SMTAFE-Engineering/CNC-Lathe-Docs/Alex's Files/Mechanical Group Rosani Sean and Alex.docx

Mechanical Group Rosani, Sean and Alex

Tasks:

- Figure out Forces that act onto the ball screw, the chip area and etc. Miguel
- Values of the lathe to be found and measured: Miguel
    - Speed of Rotation
    - Torque Needed to Cut Metal
    - Variables
    - Z is the Ball Screw
    - X is the Cutting Tool
- NSK Ball Screw, Basic Info (Alex Finished, waiting for additional data)
- Find out the Cutting Tool (Need to ask Ross)
- Find the material properties of MILD STEEL can be Generalized (Sean)
- Find the information about Cutting into Material (Sean, )
- How to use the Lathe Guide Step by Step (Sean)
- View of the Lathe, Illustration of the Lathe labelled (Rosani)
- Specifications of the Lathe
    - Specifications
    - Dimensions
- Excel Information/Equations of Cutting Forces and Calculations (Rosani)
    - Cutting Force Calculations
    - Correction Factors
    - Machine Power Requirement
- Gantt Chart (Rosani)
- Contract (Rosani)
