SMTAFE-Engineering/CNC-Lathe-Docs/Alex's Files/Tracks for lathe door in Perth.docx

Tracks for lathe door in Perth

http://www.midaliasteel.com/products/sliding-door-hardware/

https://www.robotbuildingsupplies.com.au/product/ed2-sliding-door-track/
