SMTAFE-Engineering/CNC-Lathe-Docs/Final Report/M227586 Corey Wise/FINAL REPORT CNC LATHE.pdf

South Metropolitan
Tafe
11/2017

M227586
ADV DIP
Of ENGINEERING

## COREY WISE

# LATHE AUTOMATION

CNC LATHE

TABLE OF CONTENTS 1

CNC LATHE

ABSTRACT
INTRODUCTION
BODY
CONCLUSION
RECOMMENDATION
REFERRENCES
APPENDIX

ABSTRACT | 2

The Objective of this project is to deconstruct an old manual lathe and reconstruct it as a more modern CNC lathe, which mean an automated system using computers, encoders and newly designed parts by the team

INTRODUCTION | 3

CNC lathes are now a staple and important part of the manufacturing industry since most or all Lathe are CNC because its computerized and easily able to manufacture objects beyond the skill level of most machinists and create otherwise timely and technically challenging materials with ease.
During our time trying to finish this project our main object is to finish the Z-axis and X-axis and possibly the tool changer, unfortunately not all the objectives we aimed for we accomplished
Throughout this report I will identify things I have done and helped with during the duration of the report
The reports body will be separated into three parts design, manufacturing and research
Then I will discuss what could have been done better and more efficiently

BODY - RESEARCH 4

The Body will consist of 3 main steps the we took as a whole team during every specific task, which was first to research it then to design either a work around or a better design and lastly to get it manufactured.

## RESEARCH

During the starting step of the Project we were tasked with research specific part of a CNC LATHE and compiling that knowledge in a collective program called GITHUB, I personally was tasked with finding out the base prices of CNC lathe and also compiling them into a bill of materials so the cost of such extra materials such as motors and encoders as well as sensors, came into play. Finding such prices of encoders and servo motors was also a part of my specific research what was there RPM and finding there Torque. Finding a coolant pump and how big we needed it and what specific coolant we would be using was also needed. See appendix 1
When researching the ball screws with Miguel we used a formula to make sure it could with stand the load that would be forced upon the axis
Researched ball screws, the formula need and using this calculated the ball screws needed for our lathe

# LLLLLLLL = CCℎuuuuuu aaaa aa aa vv vv vvvvvv (RRRRRR) × FF

## mmmm

# aaaa aa aa vv vv vvvvvv (RRRRRR)

# TTbbbbbbbb ssssssssss = FFmmmmmm × LLLLLLLL 2ππ × ηηbbbbbbbb ssssssssss × 1000

With these two formulas and also the breakdown of our forces and determining the cutting forces (produced by Miguel) we were able to obtain the toque on the ball screws. For the z-axis or The Apron we got a total force of 4632.5N

# FFmmmmmm = FFFF + FFAA = 1182.5NN + 3450 NN = 44444444. 5555

Then using the above ball screw formula we get 8.2Nm
And apply the safety factor we obtain the final 10.9Nm Repeating this method for the x-axis or tool post

BODY RESEARCH/DESIGN 4
We get 22 22. for total collective force which makes our ball screw torques

5.1Nm which makes it 6.8Nm with a safety factor.
I also did extensive research on the CNC Lathe Cover and what type of material what slide would work the best, and what type of shape would be acceptable for us to build given our motors being unattached to our CNC saddle.

## DESIGN

After extensive research we approached the design stage of the project, which started off with pulling apart the CNC lathe and every person taking a few bits of the lathe and designing in AUTO CAD to create a virtual assembly of the lathe so we design any extra bit to add onto the lathe so we could add such thing as the ball screws and servo motors.
I personally designed the X axis saddle and the Lathe cover, and the old manual tool changer which was not needed for the design so it was scraped before finish.

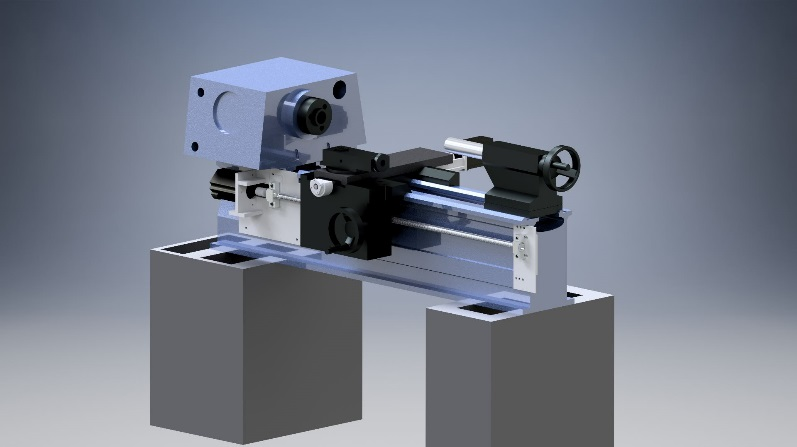
[picture p92: figure]
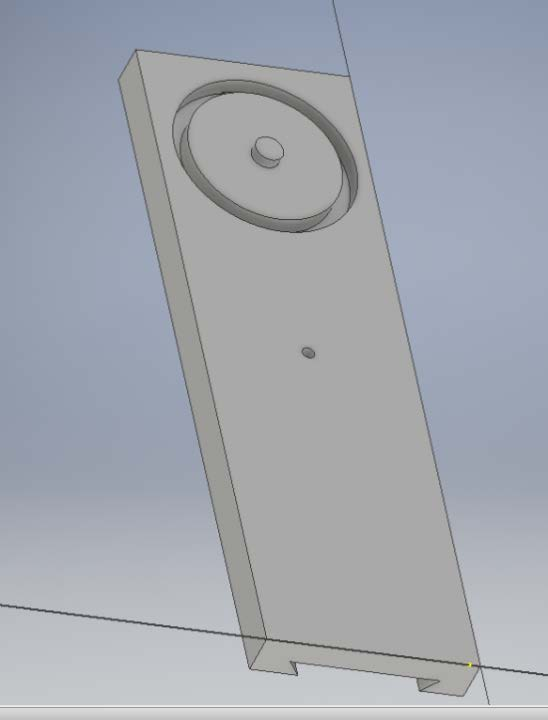
[picture p93: figure]
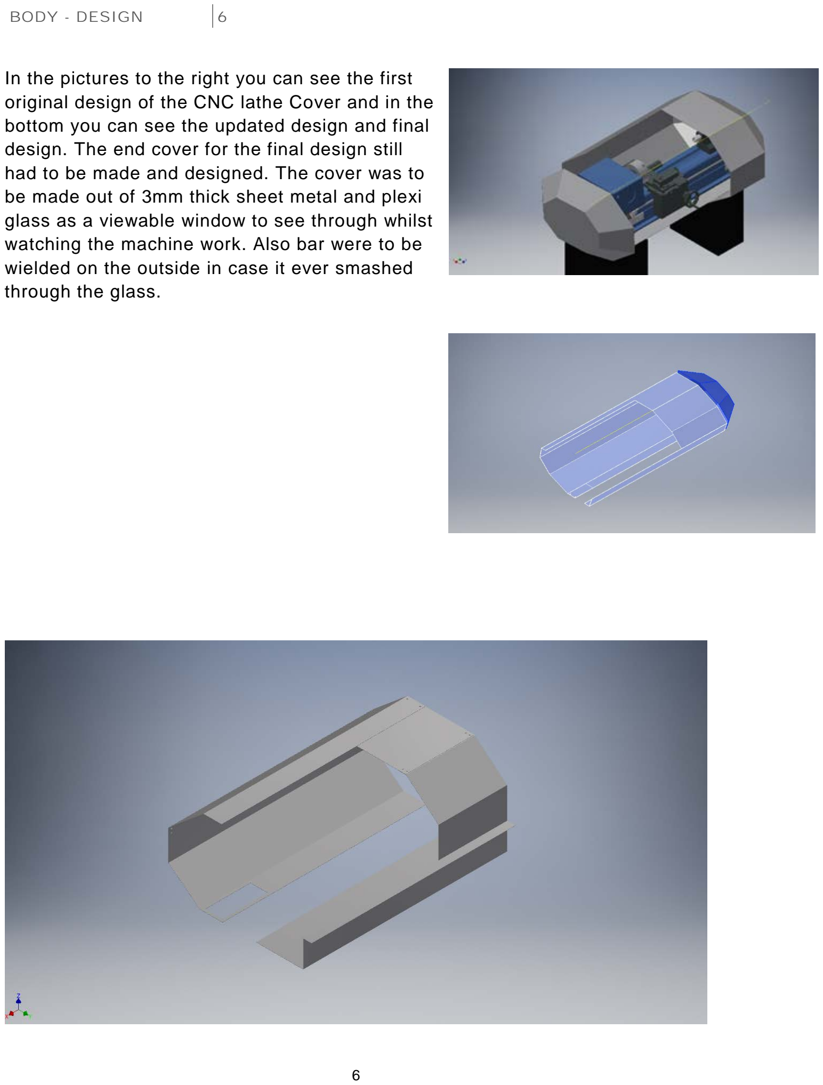
[picture p94: page 7]

BODY - DESIGN | 6

In the pictures to the right you can see the first original design of the CNC lathe Cover and in the bottom you can see the updated design and final design. The end cover for the final design still had to be made and designed. The cover was to be made out of 3mm thick sheet metal and plexi glass as a viewable window to see through whilst watching the machine work. Also bar were to be wielded on the outside in case it ever smashed through the glass.

BODY – MANUFACTURING/CONCLUSION 7

## MANUFACTURING

During my time on the project the only thing I had to manufacture was the lathe cover but was taken over fully by Sean after the first design to make the drawing but it was never manufactured. The design can be easily adapted into a manufactured part later. Things like the ball screw supports were properly manufactured and the ball screws selection were purchased and added which are the main things need to at least get the lathe running to standard but it would not be safe until the cover was installed

## CONCLUSION

In conclusion it was obvious that the design and manufacturing process of our project were clearly strung out and ineffective in achieving an end result as a group our efficiency in completing designs and also bring most objects to the manufacturing stage could have been far more desirable.
I could have also be more efficient with my time and help out other parts of the project that I was not actually a part of.
This was about the extent of my input during this year it wasn’t as much as it could have been but I was looking forward to getting the assembly stage and getting more hands on because I think that is where I could of displayed more of my practical skill such as wielding and machining to help complete the physical product more than the virtual product.
There was work to be done but our communication as a team was lacking know what was free to be worked on or who needed help or anything that need to be improved.
In regards to the project as a whole the virtual side of things was finished but the physical was not

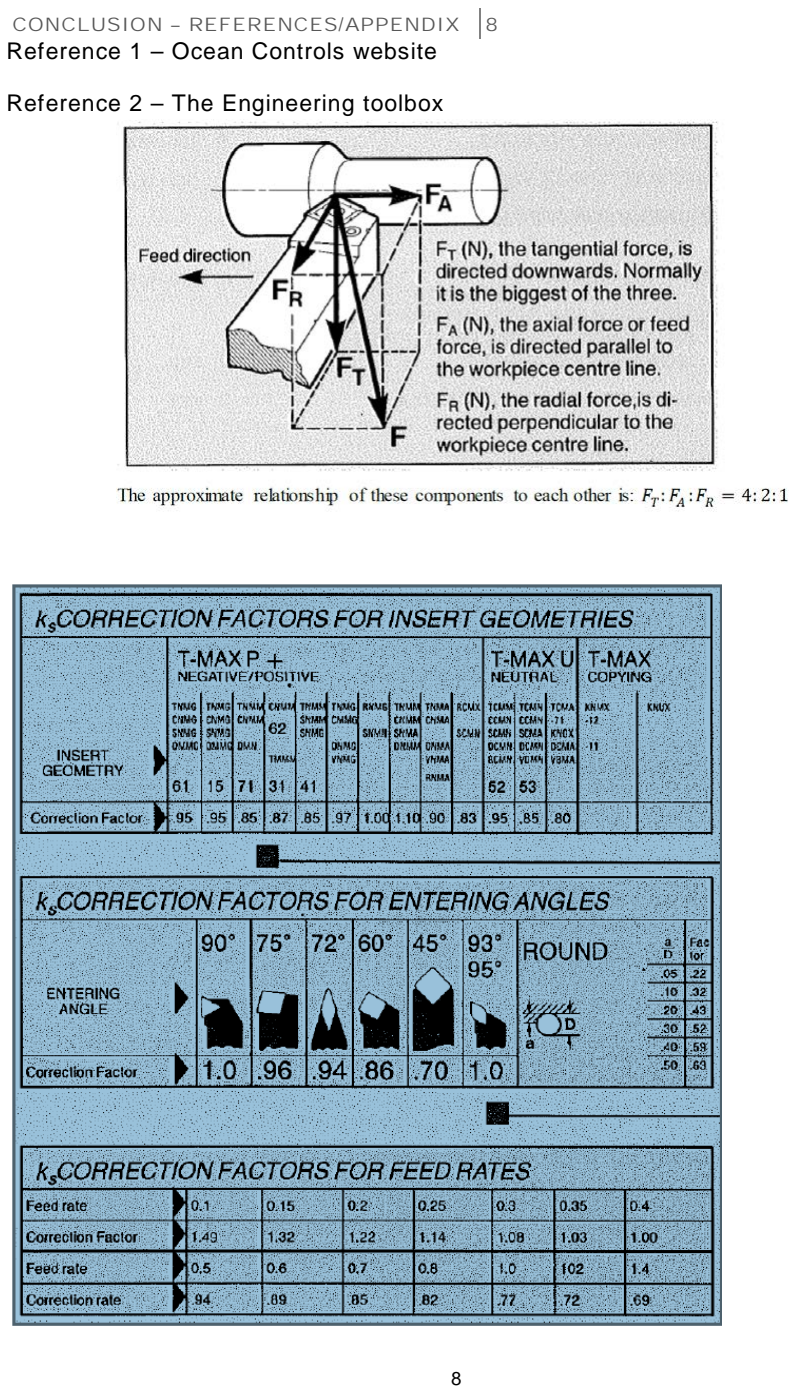
[picture p95: page 9]

CONCLUSION – REFERENCES/APPENDIX 8 Reference 1 – Ocean Controls website Reference 2 – The Engineering toolbox

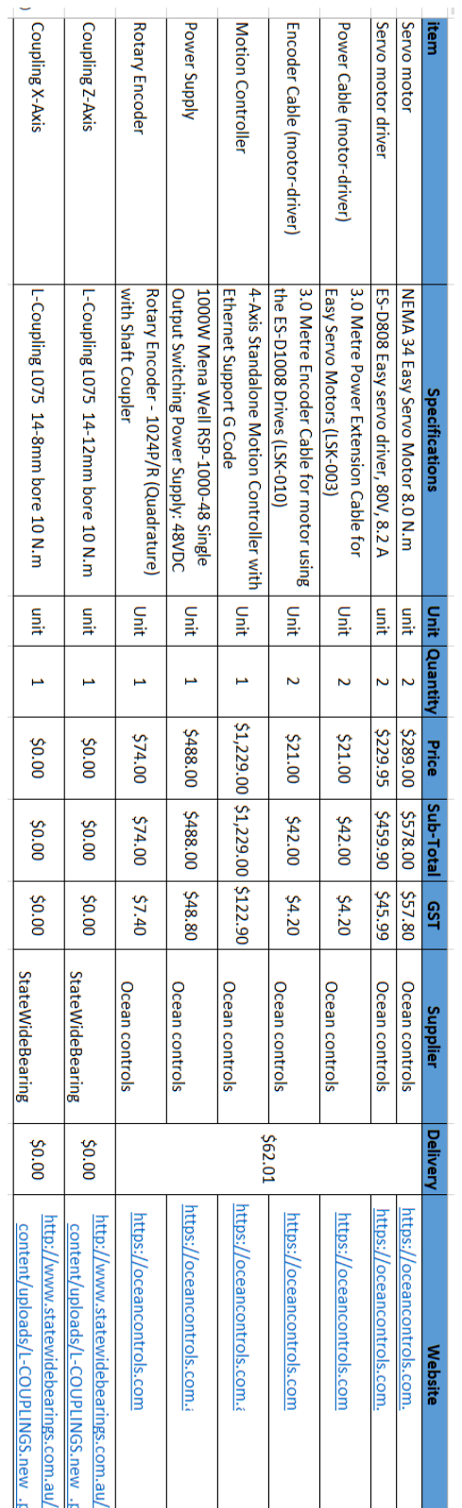
[picture p96: page 10]
