SMTAFE-Engineering/CNC-Lathe-Docs/Final Report/M228540 Miguel Martins/Final report.pdf

# LATHE AUTOMATION

Tuesday 28/11/2017
Advance diploma of mechanical engineering Miguel Martins M228540

## Contents

## Introduction

Lathe has been an important tool for the industrial revolution. It has been considered as a must-have tool for the manufacturing industry offering reliable and accurate result. However, in the last decade automatic lathes have taken over this process due to its low cost, manufacturing errors reduction and human safety benefits. Furthermore, the intent of stepping into this technology is fundamental giving basic comprehension and skills required by today’s challenges.

This report consists of four sections:
1. Modelling
2. Calculations.
3. Manufacturing.
4. Assembly.

In this order, modelling refers to the process of digitalizing a physical component into a computational 3D model while calculations will involve some research and force analysis develop during operation. These two sections will be carried out individually where every person will have a different task while the manufacturing process will be operated by an authorised machinist. Moreover, assembly, wiring and programmable set up sections will be done in collaboration.

By the end of this project, operators should be able to machine a material by giving it a specific drawing file which will be then translated and transformed into GCODE files and lastly be readable by the motor controllers.

## Modelling

The following components were part of my collaboration to the team. Apron

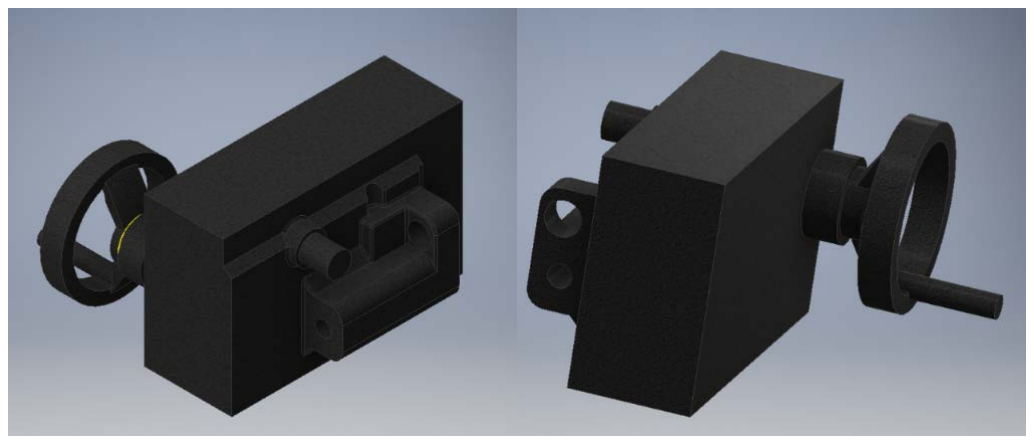
[picture p97: figure]

Bed

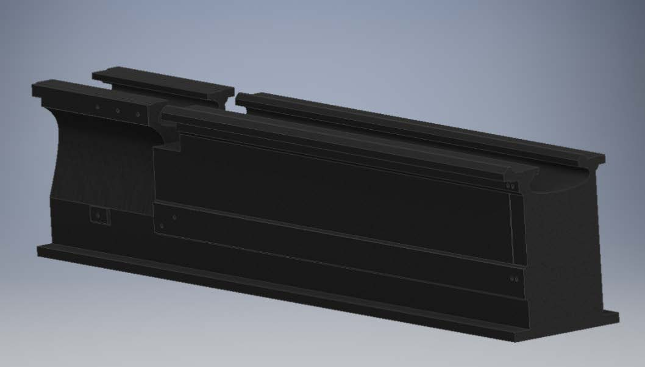
[picture p98: figure]

## Calculations

Torques and forces exerted by the lathe were calculated in order to select both motors and ball screws.
Initial stablished parameters:
Predominantly material for workpiece | High Carbon Steel | N/A
Depth of cut (max) | 6 | mm
Feed rate (max) | 0.5 | mm/rev
Chuck angular velocity (max) | 22 - 1800 | RPM
Coefficient of friction metal-metal | 0.16 (The Engineering ToolBox, 2017) | N/A
Z-axis weight | 50 | Kg
X-axis weight | 25 | Kg
Manual angular velocity | 120 | RPM
Lead angle accuracy | 0.05 | mm
Ball screw length to be used for the Z-axis | 1100 | mm

CNC lathe is required to be driven by ball screws and servo motors for their lowest factors of frictions and accuracy respectively. Therefore all following calculations are aimed at selecting a ball screw and a servo motor that can overcome the maximum torque, velocity and forces developed by the lathe.

For cutting force calculation:

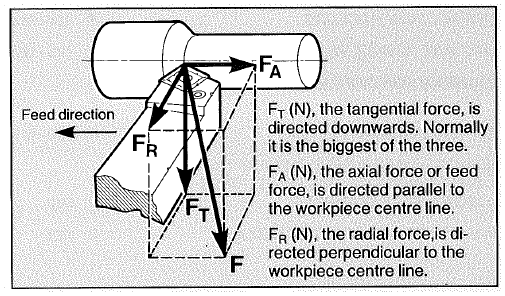
[picture p99: figure]

The approximate relationship of these components to each other is: FFTT: FFAA :FFRR = 4: 2:1

Tangential cutting force (FFtt ) may be determined by:

# FT (N) = ks × a × s

Where | kkss = | specific cutting force (N/mm²)
a | = | depth of cut (mm)
s | = | feed (mm/rev)
As kkss = 2300 N/mm² for a workpiece of high carbon steel, it need to be corrected by three (3)

factors which are insert geometry, entering angle of the tool and the feed rate chosen. See appendix 1 for more information.
Assuming all these factors are equal to one, kkss is:

# kkss = 2300 × 1 × 1 × 1 = 22222222 NN/mmmm22

Thus,

# FFTT = 2300 NN/mmmm2 × 6 mmmm × 0.5 mmmm/rrrrrr = 6666 NN

And:

# FA = FT

2 = 6900 NN
2 = 3333 NN

# FR = FT

4 = 6900 NN
4 = 1111 NN

Since the lead angle accuracy is 0.05 mm and the effective thread length is greater than 1000 mm, the accuracy grade for the ball screw will be C5 Precision Ball Screw. Furthermore, most ball screw can provide an efficiency of 95%.

Additionally, the ball screw lead may be obtained as follow:

# LL LLLL =

# CCℎuuuu aaaa aa vv vvvvvv (RRRRRR) × FF rr rr

### mmmm

## rrrrrr

# aaaa aa vv vvvvvv (RRRRRR) = 1800 × 0.5

120

# = . mmmm/rrrrrr

Rounding up the theoretical lead to match a standard lead screw ball from manufactures, lead is equal to 10 mm/rev.

Once cutting forces and ball screw’s lead have been calculated, forces due to friction and lathe’s components weight must be included for both X and Z axes. Thus,

Z-axis (Apron) | X-axis (Tool post)

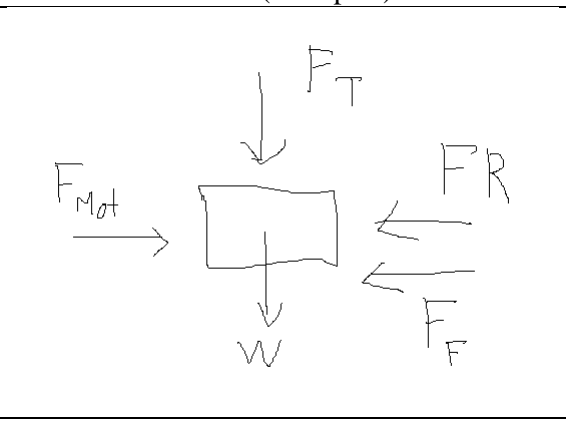
[picture p100: figure]
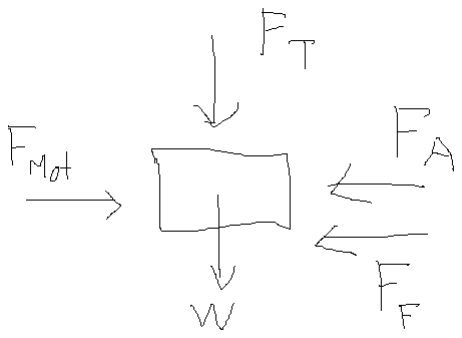
[picture p101: figure]

WW = 50KK × 9.81 mm/ss2 = . NN FFFF = (6900NN + 490.5NN) × 0.16 | WW = 25KK × 9.81 mm/ss2 = 22 . NN FFFF = (6900NN + 245.5 NN) × 0.16
= 111111 . FFmmmm = FFFF + FFAA = 1182.5NN + 3450 NN | = 1111 .22 FFmmmm = FFFF + FFRR = 1143.2NN + 1725 NN
= . | = 22 .22

# TTbbbbbbbb ssssssssss = FFmmmm × LL LLLL 2ππ × ηηbbbbbbbb ssssssssss × 1000

# = 4632.5NN × 10 mm/rev 2ππ × 0.9 × 1000 = . 22 NN

# TTbbbbbbbb ssssssssss = FFmmmm × LL LLLL 2ππ × ηηbbbbbbbb ssssssssss × 1000

# = 2868.2NN × 10 mm/rev 2ππ × 0.9 × 1000 = . 11 NN

Considering all the previous values and space limits, the ball screw selected could be found on appendix 2. Furthermore, a 3D representation of the ball screw was drawn by using the dimensions shown on the appendix 2.

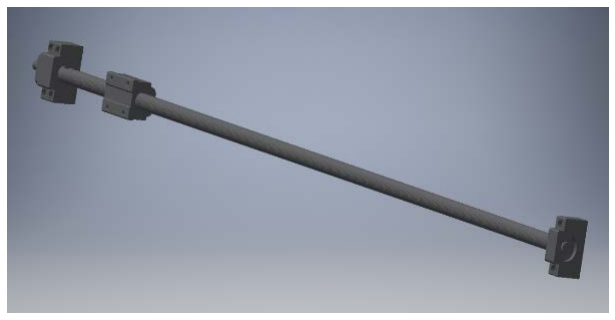
[picture p102: figure]

Finally, selecting the motor is done by using the maximum torque calculated previously and the assumed rotational speed. The motor details are shown on appendix 3. (Ocean Controls, 2017)

## Manufacturing

Having all the dimensions for the ball screw and the motor to be used, supports can be designed and adapted to the lathe in a convenience manner.

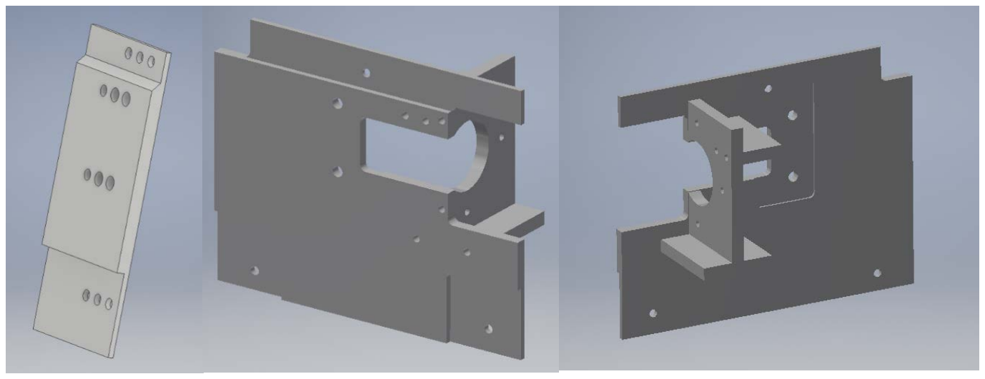
[picture p103: figure]

Then, manufacturing drawing were created and handed to the machinist.

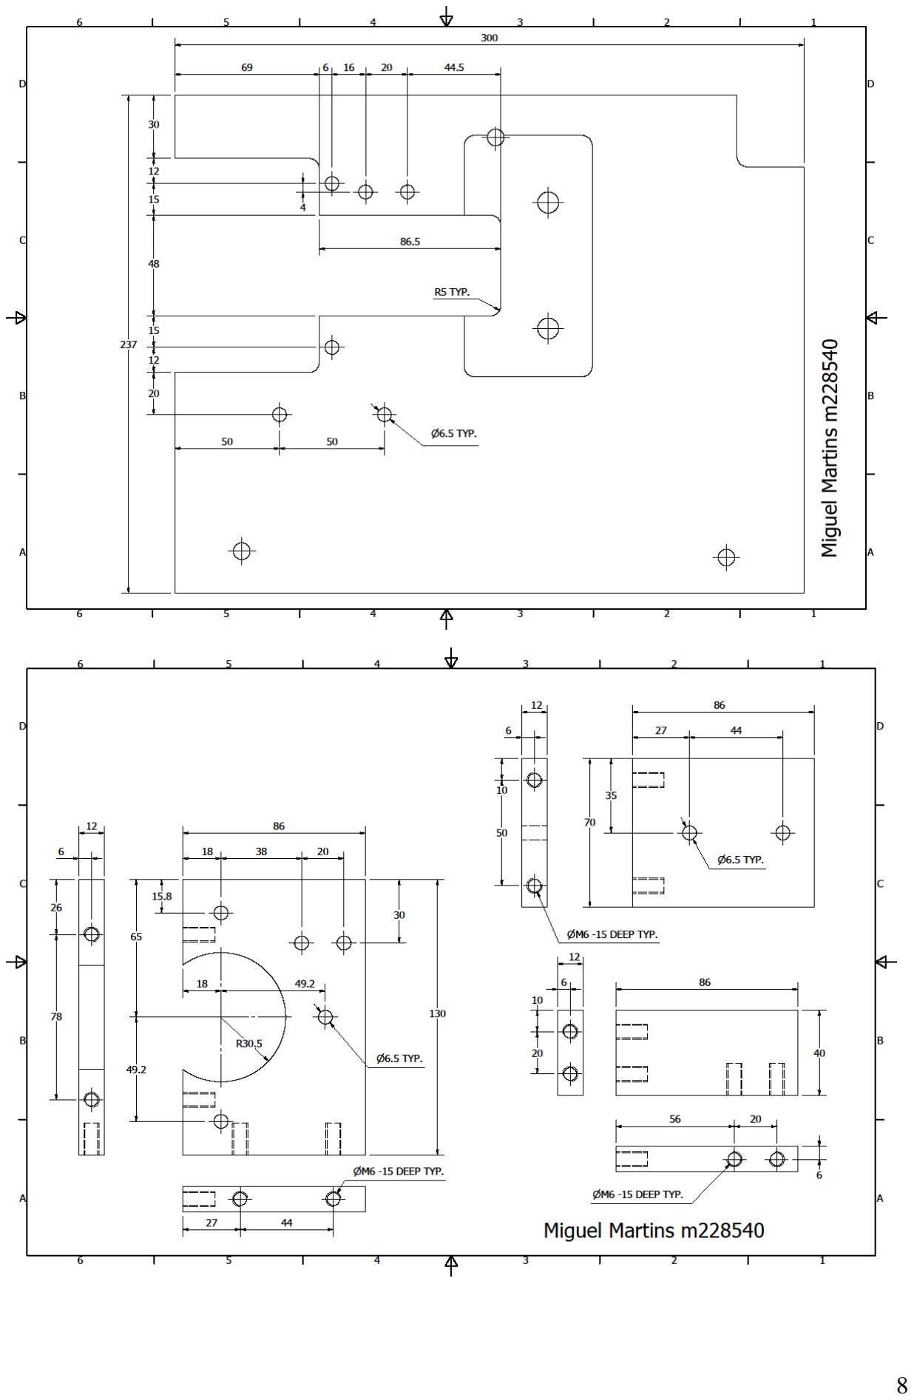
[picture p104: page 8]

## Assembly

Unfortunately, this section was only accomplished on a 3D model because machinists and lectures were unavailable. However, supports were machined partially and some modifications were added to it afterwards due to some discrepancy on the flexible couplings.

In addition, the final 3D model was designed to allow movements and test the maximum possible displacements after all components being assembled. Finally, the 3D representatio n of the final assembly is:

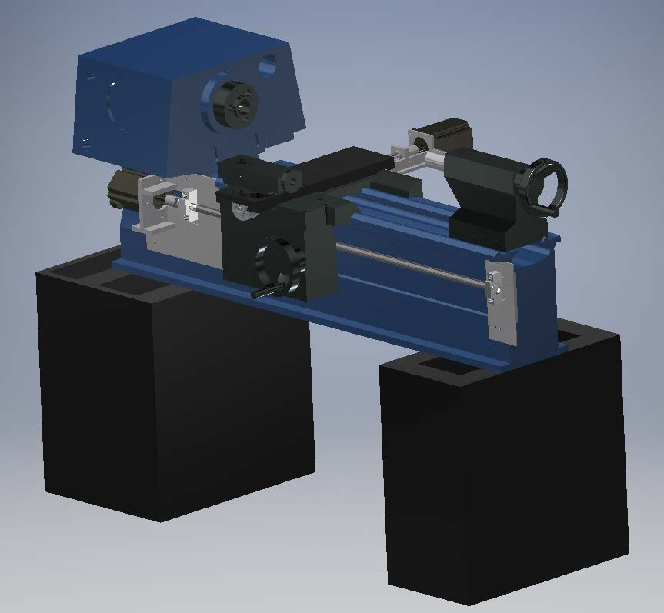
[picture p105: figure]

## Conclusion

Although we finished off the virtual representation of the final assembly, the physical assembly could not be done due to circumstances out of our control. Furthermore, all the basic selections like motor and ball screw were carried out without major difficulties. As mention previously, what was done of the supports was also tested on the bed and fitted correctly with aligned holes and proper dimensions.

Regarding the z-axis configuration which was my task, there was not need of modifying neither the apron nor the bed for the nut or ball screw’s supports to fit in. This was accomplished by selecting the most suitable ball screw and playing around with the design of its supports. As it can be seen, these supports were machined on both front and rear surfaces which avoided us modifying the apron or bed.

Finally, all the calculations were proven to be the most suitable for our application due to a interactive spread sheet on Excel were initial values can be changed and see the result right away. It is worth mentioning these initial values were obtained from machinist and lecture’s experiences and used as a starting point or initial reference.

## Recommendations

In order to complete this project, ball screw’s supports must be finished off as indicated on manufacturing drawings.

Motors must be place in a convenience way where cables go towards the motor controllers

## References

Ocean Controls. (2017, July 18). NEMA 34 Easy Servo Motor 8.0 N.m. Retrieved from oceancontrol.com.au: https://oceancontrols.com.au/MOT-184.html
The Engineering ToolBox. (2017, July 18). Friction and Friction Coefficients. Retrieved from Enginnering ToolBox: https://www.engineeringtoolbox.com/friction-coefficients-d_778.html

## Appendices

Appendix 1

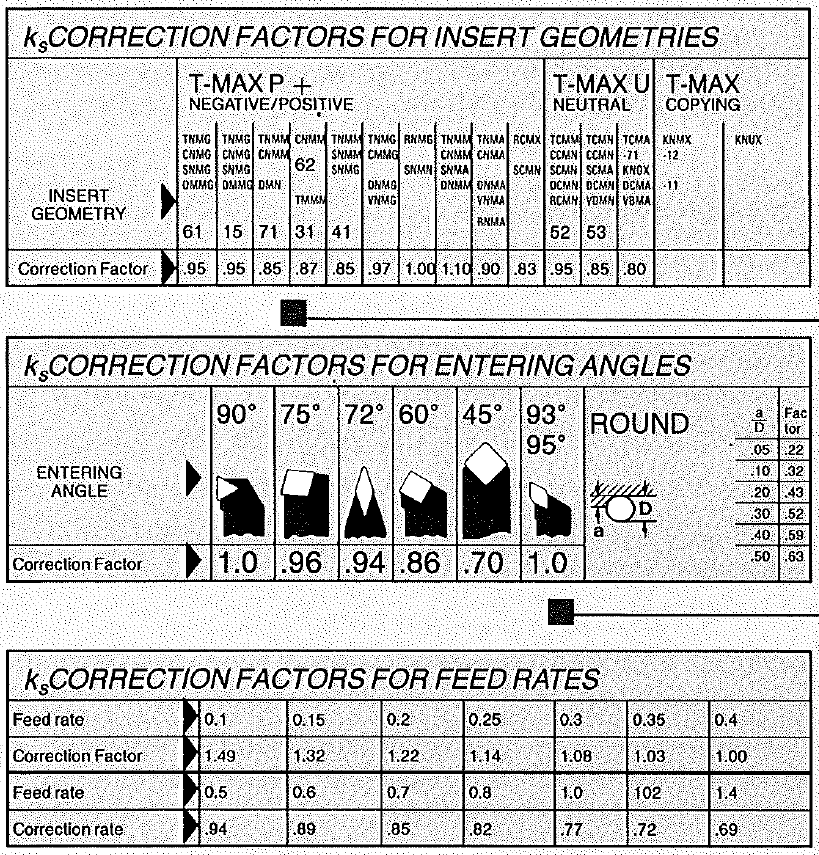
[picture p106: figure]

Appendix 2

12

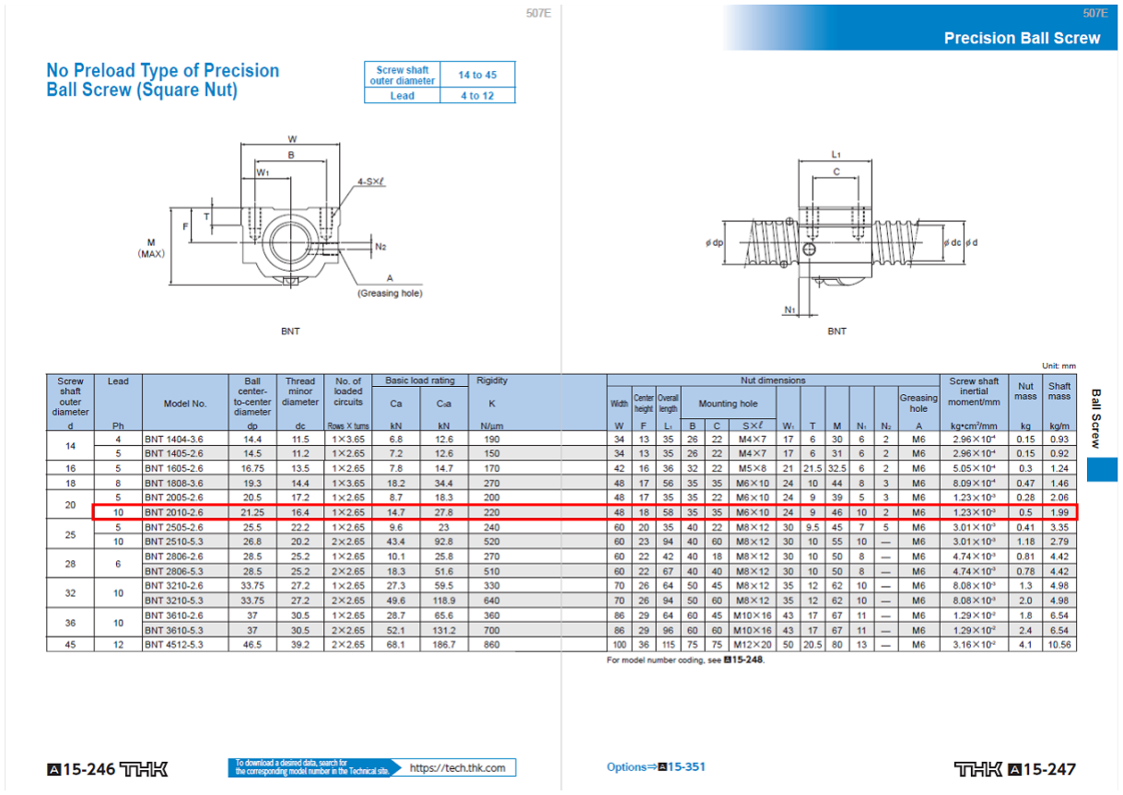
[picture p107: figure]

Appendix 3

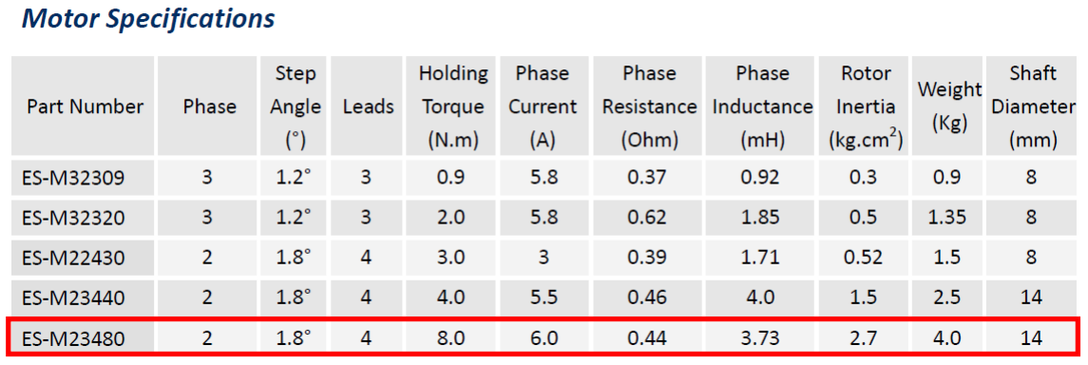
[picture p108: figure]

13

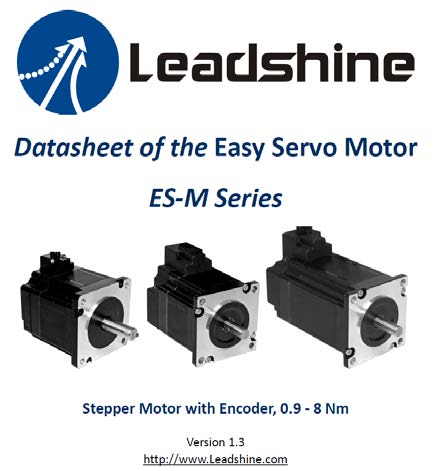
[picture p109: figure]
