SMTAFE-Engineering/CNC-Lathe-Docs/e-Portfolio 10-02-17.xls

Sheet: Sheet1
 | Qualification Details: |  | ADVANCED DIPLOMA OF ENGINEERING (Mechanical)
 | Training Package Code & Title: |  | MEM60112 Metal And Engineering Industry Training Package
 | Qualification Code & Title: |  | MEM60112 ADVANCED DIPLOMA OF ENGINEERING | State code: J368
 | Lecturer(s): |  | Ross Jarvis, Vivian John
 | Student: |  | ROSANI ANIUSKA MUJICA ESAA
 | As you progress through the project, you need to provide evidence of your own progress. Use the DAS as a guide as to when the unit elements and the criteria are likely to be covered in class. Interact with your lecturer and discuss how student activities relate to unit elements and criteria.
 | You are required to fill in your evidence in the Student Evidence column of this spreadsheet. (Note - this is to be provided as electronic evidence).
 | Evidence can be any relevant activity in which you have participated. E.g. Calculations on a spreadsheet, photos of the white board brainstorming sessions, drawings, work in the workshop (what you did, machines you used), research you did, documents you generated, etc.
 | Providing multiple evidence from differing dates increases your evidence of competency.
 | Use the filter on the top of the 'Category' column to filter to the approprate Category to assist students to enter similar evidence across the different Units.
MEM # | Description
MEM 09155A | MEM09155A PREPARE MECHANICAL MODELS FOR COMPUTER-AIDED ENGINEERING (CAE)
Element | Criteria | Required Evidence | Student Evidence | Category
1 Identify model parameters. | 1.1 Identify the engineering context of computer modelling | Identified benefits of CAD Modelling such as cost efficiency, time efficiency,ease of usage hardware required, ease of taking the model into prototyping on to production. Show your understanding of CAD Modelling and how it relates to manufacturing. Give an example of you using CAD CAM to produce a product or model. Give an example of rapid prototyping eg 3D printing, laser cutting etc. | I draw one part of the lathe that was assembled together with the other parts of the lathe. So, we could do a 3D modelling of the lathe machine in INVERTOR in order to later do some simulations. | CAD Modelling
 | 1.2 Identify sustainability issues related to required models | Show evidence of the design consideration need for sustainable design. Consider the material used, time taken, material wastage, end of life recycling, maintenance, serviceability. Give an example of a product you have designed, the manufacturing technique you will employ and another technique which may be used. For example you coule use CADCAM to produce a shaft or a more traditional method with the use of a drawing and a manual lathe or manufacture using a 3D printed part. |  | Sustainability
 | 1.3 Identify work health and safety (WHS) and regulatory requirements related to modelling processes and materials | WHS is a constant ongoing consideration. Show evidence of your participation within the simulated working environment and your constant acceptance of designing an inherently safe system. For example your use of the FABLAB and the safety which is required. OR when we visit a factor what safety requirements you had to follow. Also show how you have considered WHS in your design ensuring the ability to install and maintain the product safely. | When we were pulling apart the old lathe machine, we needed to use EPP to be sure to be out of risks og being injured. When making the design of the new lathe, we considered the protective cover, as well as interlocks (o'dear and o'shit bottom), sequence checker (wacth dog) to maintain the voltage level on the system. | OHS
 | 1.4 Identify the virtual or physical model parameters, form, function and features | During the design process you are required to keep the original intent of the model in constant review. Your design needs to consider how the CAD model will be prototyped examined for project outcomes and then prepared for production. Show how you have kept the design intent in mind. For example keep an archive of the design process. This will show how you have developed the project from initiation through to the final design. You will need to have used FEA to identify the use and constraints of a component within the design. | We are keeping the same travel distance from the previous lathe. Furthermore, we drew the parts in a 3D model with the same measurements and then assembly them together to simulate its performance where we later are going to set the limits switches, the position of the ball screws, the servos, and other accesories. | CAD Modelling
 | 1.5 Identify required model generation processes, including any required graphics generation, post-processing and physical modelling | This project is to be designed on a 3D CAD parametric platform. It will need to have AS1100 drawings, a full working model. It also may required a rapid prototype model made using the current FABLab facilities. You need to identify your participation in the project and how you used the facilities available for your project. You can use some of the items which you designed for the project. Also you building of the items of the project and a model you have produced. | Download the ball screws, nuts and supports models from the THK webside, where they have the prototypes under the standards that later we use to position them in the model and set the tolerances. | CAD Modelling
 | 1.6 Identify licensed technical and professional assistance for advice, as required | You need to collect evidence as the design progresses from concept to finished model. This evidence will clearly identify your contact with various stake holders as well as professional guidance from appropriately qualified people. For example your lecturer, firms supplying materials and others. | When Miguel did the calculations for the selection of the servo motors, a stronger servo motor was needed for the biggest ball screw (Z-axis) as the prices for the small ball screw (X axis) the big servo motor were the same, the lecturer advice to purchase two big ones. | Expert
2 Develop model | 2.1 Generate initial graphical model | Show your design as it stands as a first iteration of the project. This may be done during the early stages of the project. This is to show your design intent and how it will progress and be refined in time. | Drawing the saddle with the same measurement that I later needed to modify (cutting 50x50 square) to place the bracket to place the nut of the X axis. | CAD Modelling
 | 2.2 Undertake initial consultation on model with stakeholders and adjust, as required | To fulfil this requirement you will need to write a proposal in engineering term which sets out the project as you understand it. This will then be part of the discussion you will undertake with the stake holders. At a minimum you will need to discuss the project with your lecturers and with the college Project Manager. If you project is for an external company then you will need to show consultation with the company. | A proposal was not written at the beginning, but a reunion and a brainstorming took place when creating the three teams in charge (mechanical, control and electrical). For example, the types of sensors and their positions. | Project
 | 2.4 Trial model for purpose and complete investigative analysis or produce physical model | The model will need to be functioning within the CAD package. All restraints and components fully defined with the model functioning in compliance with the original design intent. This may require the production of a prototype using on site facilities. Your evidence is the completed model in the CAD parametric package. Also any prototype which was produced. You need to clearly identify your participation in this project. | Once, we got the final assembly, we set the travel distance of the cross-slide, tail stock the saddle, bottom tool bit, apron. | CAD Modelling
 | 2.5 Evaluate model against design criteria with stakeholders and make adjustments, as required | When you are confident your model meats the design intent of the project brief you then need to have a meeting with the appropriate stakeholders to ensure a smooth handover. This will be done at the end of the project keeping in mind you have been in contact with the stake holders during the life of the project. | n/a | Project
 | 2.6 Engage appropriate licensed technical and professional assistance for advice, as required | Any design needs to comply with Australian Standards. All critical components are checked with FEA and/or calculations and all licensing requirements are met within the design. Examples of Licence requirements are: Electrical, Gas fitting, Plumbing, RTA etc. You need to document your participation. You need to show at least one problem within the project which you have solved with the use of consultation with others. This consultation may with others in the team, use of professional information, lecturer input, external suppliers etc | When I was doing the Risk Analysis, I followed the Australian Standards. When doing this, I realised that a cover was needed for the lathe so the swarf do not harm the machinist, for instance. | Expert
3 Finalise modelling | 3.1 Prepare final model | To pass this unit a complete model with all components, constraints, fits and tolerances needs to be produced This model will contain a GA, Parts list, costings and Detail drawings as required all to AS1100. The model will also need to be rendered and some AVI produced. You are not expected to do this in isolation. This is a team project however you need to clearly identify your participation in the project and have your participation acknowledged by your team. | Once everyone posted their drawing in GItHub, I just did the constraints of the bed with the saddle. I did some changes in my drawing (saddle) to make sure that everything fits. | CAD
 | 3.2 Report and demonstrate results | A report and all relevant documentation will be produced and articulated to the stake holders. This will take the form of a formal meeting where the project and all relevant materials is handed over. The report will be as per an Engineering report. You will need to clearly identify your participation within the project and your responsibility in the preparation of the report The report will be a group report and your participation will be recognised by all team members including your lecturer. | progress monthly reports | Project
 | 3.3 Provide documentation, instructions, models and files, as required |  | progress monthly reports + github | Project
 | Required Knowledge |  | Required Skill
 | · advantages and disadvantages of CAM using modelling compared to traditional manufacturing methods· advantages and disadvantages of CAM using modelling compared to traditional manufacturing methods | · mathematical model analysis options, such as:· mathematical model analysis options, such as: | · reviewing features, functions and context of engineering modelling, including imminent future developments· reviewing features, functions and context of engineering modelling, including imminent future developments
 | · implications to be taken into account when modelling (e.g. efficiency of production, generation of waste and life cycle considerations)· implications to be taken into account when modelling (e.g. efficiency of production, generation of waste and life cycle considerations) | · finite analysis of heat flows· finite analysis of heat flows | · comparing available software, functions and features· comparing available software, functions and features
 | · typical mechanical components, assemblies and layouts suitable for modelling· typical mechanical components, assemblies and layouts suitable for modelling | · finite analysis of stresses and deflections· finite analysis of stresses and deflections | · communicating, participating and negotiating with:· communicating, participating and negotiating with:
 | · software functions and features· software functions and features | · physical modelling options· physical modelling options | · stakeholders, team, cross-function support groups and experts· stakeholders, team, cross-function support groups and experts
 | · model creation techniques, including:· model creation techniques, including: | · traditional, current and emerging modelling methods· traditional, current and emerging modelling methods | · appropriate licensed technicians and professionals· appropriate licensed technicians and professionals
 | · using and manipulating coordinate systems· using and manipulating coordinate systems | · WHS and regulatory requirements, codes of practice, risk assessment and registration requirements relevant to modelling task· WHS and regulatory requirements, codes of practice, risk assessment and registration requirements relevant to modelling task | · modelling using a comprehensive range of techniques, such as:· modelling using a comprehensive range of techniques, such as:
 | · creating 3-D entities, ruled and revolved surfaces· creating 3-D entities, ruled and revolved surfaces | · job requirements that may create a need for licensed technical and professional services assistance· job requirements that may create a need for licensed technical and professional services assistance | · creating and manipulating 3-D entities· creating and manipulating 3-D entities
 | · creating solids, editing and combining solids· creating solids, editing and combining solids | · modelling compared to traditional representation methods, including:· modelling compared to traditional representation methods, including: | · using library files and adaptations· using library files and adaptations
 | · manipulating entities and solids· manipulating entities and solids | · pen and pencil graphics compared to wire frame, surface and solid models· pen and pencil graphics compared to wire frame, surface and solid models | · accessing supplier catalogues and databases· accessing supplier catalogues and databases
 | · library files· library files | · computer animations compared to transparent overlay mobiles to test clearances and motions· computer animations compared to transparent overlay mobiles to test clearances and motions | · creating dimensioned orthographic projections from model· creating dimensioned orthographic projections from model
 | · manipulations of solids and library files· manipulations of solids and library files | · solid models compared to isometric representations· solid models compared to isometric representations | · extracting dimensional properties from model:· extracting dimensional properties from model:
 | · 3-D graphics from models, including rotated views and sections· 3-D graphics from models, including rotated views and sections | · computer library files compared to the use of reference charts and catalogue information · computer library files compared to the use of reference charts and catalogue information | · post-processing model for analysis or physical modelling· post-processing model for analysis or physical modelling
 | · dimensioned orthographic representations from models· dimensioned orthographic representations from models | · Obtain sign-off· Obtain sign-off | · finalising modelling by:· finalising modelling by:
 | · typical modelling processes, including:· typical modelling processes, including: |  | · completing work· completing work
 | · computer modelling |  | · gaining approval and commissioning work
 | · post-processing |  | · providing documentation and reports, as required
 | · prototyping and model manufacture |  | · obtaining sign-off
MEM | PERFORM ENGINEERING ACTIVITIES
22001A
Element | Criteria |  | Student Evidence | Category
1 Identify and implement engineering practices. | 1.1 Engineering practices applicable to engineering activities are identified. | you need to collect evidence as the design progresses from concept to finished model. This evidence will clearly identify your contact with various stake holders as well as professional guidance from appropriately qualified people. For example your lecturer, firms supplying materials and others. You will need to show calculations you have undertaken to solve a project problem. You will need to show you are working in the discipline you are studying. This evidence needs to be collected during the entire project so you can show your continues engagement in the project. | A number of calculations I needed to done in order to fit the nut inside the saddle as well as the design to support it. In addition, calculation to do the base support of the motor for the ball screw of the X-axis; this is for the base to be able to support the motor we needed to add trust support brackets (triangular or rectangular). | Design
 | 1.2 Factors, conditions and contexts integral to effective engineering practice are researched and evaluated. | You participation in the project will take many engineering forms. You will need to show your participation in the research of the project. How you helped the team to solve some engineering problems. How your research helped the team progress the project. So ensure you do some research as part of the team. | When making the material list and the budget I was looking through to many supplier for the coolant pump and the coolant and reported the best option in the budget which was approved by the lecturer. | Project
 | 1.3 The application of management practices and regulatory/legal systems to engineering practice is researched and evaluated. | As a member of the team you have been given a specific task. You need to demonstrate your participation in this task and your understanding of the task you have been given. You will go through the legal system and its impact on your participation You need to show how you understand how this impacts on you and the project. For example as the manager you have a requirement to keep the project on task or as the accountant you need to ensure the project remains within the budget as the CAD specialist you need to show how you have helped others with a CAD problem as the Science specialist you have lead the team through a problem etc. | I have being updating the Gantt Chart, which I have reported to the team. | Project
 | 1.4. Elements of engineering practices are incorporated into engineering activities. | Through the course of the design we will be crossing traditional boundaries within the ethics of engineering. We will be working on a predominately Mechanical project. However in today’s engineering environment we do cross over to other disciplines. We will do some structural engineering as well as electronic engineering. You need to show your understanding of the crossover. You need to enunciate your understanding of when and why we have looked at other discipline | We have gone throught electrics in the case of the selections of sensors, switches, encoders. Also for safety reasons, the safety switches. The design also consideres safety facts such as the protective cover that it will be installed over the lathe to prevent accidents. | Design
2 Negotiate, document and monitor outcomes and performance measures. | 2.1 Technical experts and specialists are consulted as required. | As you are training in the engineering discipline you will need to continuously consult with specialists to solve some project problems. This may be within the college or you may be required to consult outside the college. This can take the form of contacting a supplier or another lecturer to help with a project problem or a specialist outside the college. You need to record how you have your contact with specialists. | So far we have not needed an outside consultant but we have had recommendations of the supplier when asking for parts. (It is proved in a email I have in my student email). | Expert
 | 2.2 Engineering options are evaluated and ranked. | As part of the training you will be given a technique of solving engineering problems. You need to show how you have participated in the project and how you have used one of these techniques to solve a problem. This may be a brain storming session or the use of the Kepler Tregoe method or another method. | Brain storming is the one that has being used the most when making decisions, as we have been working in trial and error. For example, the laminated glass is not longer being used for the cover, instead (for money reason) we are going to used the glass located in the labs' wall. | Project
 | 2.3 Performance measures for processes and outcomes are negotiated with stakeholders and documented. | As the project progresses you will document its progress. We need to keep the final outcome in mind. At the beginning of the project you work through the requirements with the various stakeholders. You ensure the project remains on track as far as the desired outcome and the time frame in which it runs. So record your participation in all of this as it will form the assessment for this performance criteria. | This can be shown in the progress reports. | Project
3 Negotiate, develop and document work instructions | 3.1 Work instructions are negotiated and documented with taskforce. | At the start of each week we will evaluate where the project is currently, we will check the GANTT chart to ensure we are on task. We will allocate task which need to be completed that week. You will need to give examples of how you have participated with this procedure. For example if you are given a task to preform either that week or over an extended time you need to document your participation and present it as you evidence. | When updating the gantt chart, I warned the team that we were behing the programmed dates, so we kept working hard to up to date. | Project
4 Perform hazard and risk analysis | 4.1 Hazards and risks associated with project are analysed. | The project will always encounter hazards and risks. These may be associated with the project itself or in the subsequent use of the device. Hazards and risks associated with project will be identified and discussed. You need to record the Hazards and risks associated with project and show how these were mitigated. You need to show how these Hazards and risks associated with project were ranked and what mitigation was taken. | we elaborated a risk mitigation analysis with the help of Excel by doing a brainstorming with the team and also searching on internet about the hazard on using a lathe. | OHS
5 Monitor progress, respond appropriately. | 5.1 Progress is monitored and responded to in cooperation and consultation with stakeholders and taskforce. | At the start of each week we will evaluate where the project is currently, we will check the GANTT chart to ensure we are on task. This is our primary tool for ensuring we remain on task. If there is a problem in meeting a critical point in the project we need to show how we will ensure the critical path is met. This can take different forms. For example we may decide to work as a group and find extra time we can all work on the project. It may mean you are required to work on the problem and bring a solution in the following week. You need to give example of when such a situation arose and how it was successfully negotiated. If no such example exists in the project you need to identify the smooth running of the project and any contingency which would have bee implemented if a problem did arise. | As we were behing when drawing the parts to do the final assembly, an extra team worked together (including me) to create the material list, to start ordening the parts, so at the moment when everything is modelled , we are going to be able to work straight away as we have got the parts. This is one of the way, we caught up. | Project
6 Conclude engineering activities appropriately | 6.1 Engineering activities are concluded in accordance with workplace and legislative requirements. | When we are working on the project we will be using Project management techniques to evaluate our progress. Your evidence of this is the continued compliance with the project outcomes. How you have read the GANTT chart, have helped keep the project on task and have complied with the legal and ethical requirements of the course. This evidence may contain you OHS compliance, your working within mechanical engineering and identifying the occasions you worked in other fields eg accounting, electronics, purchasing ect. | With regards to the gantt chart, it has allowed me to see if we are under the schedule depending on the plan and in the actual date. Therefore, the gantt chart helps to push the team to work on time. I searched about the standards to make the risk mitigation analysis such as AS 4024.1601-2006 (safety of machinery-design of controls, interlocks and guarding-guards-general requirements), AS 4024.1801-2006 (safety distances to prevent danger zones being reached by the upper limbs), AS3000 (wiring rules). | Legislation
7 Evaluate career options and develop career development strategy | 7.1 Career options are developed based on current engineering activities. | Through out the running of the project you will be required to work within a team to successfully complete an engineering project. The project is specifically designed to help you understand the requirements of the engineering industry. The project will be run as a project within an engineering company. Your participation will need to be recorded by your lecturer. You will be given tasks that you must complete within the time frame required. If you continually fail in this requirement your lecturer will require you to work on an individual task while you remain part of the project. This will be monitored by your lecturer. You will be required to sight any such breaches in this area. | I have being submitted my advances in the common-drive (GitHub) where everyone has access to the development of everyone progress which permits us to be up-to-date and compile all the information. | Career
 | Required Knowledge |  | Required Skill
 | · political, social and environmental context and possible range of particular engineering activities | · the effect of government policy on industrial education and training, immigration for industrial labour/ skills, globalisation, the quality movement, JIT and competitive or lean manufacturing on a range of applications using jobbing, batch, mass or continuous production | · research and evaluation
 | · the significance, need for continual review and maintenance of academic development, work experience, ethical practice, indemnity, negotiation, consultation and human relations with respect to the practice of engineering | · the significance and applicability of strategic industrial management, financial management, workteams, supervision and control, industrial relations, OHS&E, enterprise based agreements, chemical registers, noise abatement, industrial law to particular industrial applications and work environments | · review and maintenance of academic development, work experience, ethical practice, indemnity, negotiation, consultation and human relations with respect to the practice of engineering
 | · the application and affect of elements of engineering practice on particular engineering activities | · methods for evaluation and ranking of engineering options including the use of decision making and problem solving tools (eg. Kepler Tregoe method) | · consultation with technical experts and specialists
 | · the significance of documented processes and outcomes performance measures in the context of client requirements, industrial, social, political and economic environments | · documented work instructions in the context of the objectives of the engineering activity | · evaluation and ranking of engineering options for particular applications
 | · negotiating principles | · risk assessment tools such as "risk matrix' and "Monte Carlo" risk assessment | · designing and planning documentation for particular applications
 | · the significance of statutory requirements disaster management strategies | · long term environmental and sustainability issues associated with the engineering activity | · documenting work instructions
 | · documentation and conclusion procedures | · relevance of current engineering activities to future career options | · implementing occupational health and safety and environmental regulations, codes of practice and statutory requirements
 | · the value of a portfolio in contributing to future career options in engineering |  | · identifying and analysing hazards and risks
 |  |  | · monitoring and consultation with stakeholders and taskforce
 |  |  | · research and evaluation of engineering career options based on current engineering activities
MEM | APPLY MECHANICAL ENGINEERING ANALYSIS TECHNIQUES
14085A
Element | Criteria |  | Student Evidence | Category
1 Investigate mechanical analysis context and need | 1.1 Review the context and negotiate parameters of the mechanical design or task in consultation with stakeholders | When the design cluster is initiated you will discuss various projects or will be allocated a project. The project will be discussed and over the first weeks of the course a clear outcome will be developed. The extent of the project will be made clear to you. A contract will be developed with the stakeholders which will clearly layout the requirements of the task. You will need to present this contract as evidence of this outcome. | When designing the base support for the motor and the brackets to hold the end support of the X axis, at the beginning we used other type of nut that we possitioned outside the saddle, now that other nut was supplied this one could be fitted inside the saddle, but doing some modificationg to the saddle. | Project
 | 1.2 Identify relevant engineering scientific principles and required analysis techniques | As we work through the course we will be confronted with various engineering problems we need to solve. Ensure you record such sessions and present them as evidence of your participation Ensure your participation is acknowledged and your evidence is of a problem you solved using engineering principles. |  | Design
 | 1.3 Investigate life cycle design and sustainability implications of mechanical design or existing plant or equipment | We will be discuss the engineering requirements of your project. You need to record how the project was developed with sustainability and life-cycle in mind. It is vital today that engineering designs have an acceptable life-cycle and are sustainable. You will discuss the use of various materials and the end of life recycling. You are required to record such discussions and present them for this criteria. This may be a short note on the change of design to meet the above criteria or how this was discussed before the project commenced or how the project changed to ensure an acceptable life or how the maintenance of the product changed an initial design. |  | Sustainability
 | 1.4 Determine specification, documentation and graphical techniques required for analysis | When we are confronted with a design challenge we will employ various techniques to solve the problem. The problem will be identified, clearly annunciated, a problem solving technique identified. Physics problems will be dealt with both mathematically and with the use of software. For example your evidence may include an FEA and a mathematical conclusion to a problem. It may include a CFD outcome backed up by fluid dynamics. | N/A | Project
 | 1.5 Confirm work health and safety (WHS) and regulatory requirements, codes of practice, standards, and risk management relevant to mechanical analysis task | WHS is a constant ongoing consideration. Show evidence of your participation within the simulated working environment and your constant acceptance of designing an inherently safe system. For example your use of the FABLAB and the safety which is required. OR when we visit a factor what safety requirements you had to follow. Also show how you have considered WHS in your design ensuring appropriate standards are met. Show how you have managed a risk either within the design or when manufacture takes place. | All the safety activities have being taken into consideration in the design (for example, the cover) , but nothing else so far. However, in the risk analysis, manipulation activities were considered for a work health and safety environment. Another example, is the safety measures taken in the electrical topic. | OHS
 | 1.6 Determine available sources for any required technical and professional assistance | You are studying engineering. You have skilled lecturers at your disposal. You are required to show evidence of your use of this resource. You also have the opportunity to consult others outside the college. Your evidenced may be how you have taken a project problem to a different lecturer in a different class or how you arranged a discussion with another lecturer or how you were able to use an external source for information for example Engineers Australia meeting etc. | N/A | Expert
2 Apply mechanical analysis techniques | 2.1 Plan, schedule and coordinate the analysis task | When confronted with a problem you will need to show how the problem was solved. This will take a problem solving technique. The problem will be analysed and an appropriate method of solving the problem met. This may be the use of several resources. Once the problem is identified you will need to consult appropriate resources for example the internet, other lecturers, the use of software etc. You will have may examples during the project you need to present at least one of these for this outcome. | Using Project Microsoft office, I was able to do the Gantt chart which I could update it and control the progress of the project. | Project
 | 2.2 Create adequate and accurate calculations, preliminary graphics and maintain analysis process records | When any solution to a problem is sort then we will examine the task and decide on the appropriate method for the solution. This will take various forms and you are required to document these. For example ensuring a beam will take the desired load you can use mathematics conclusion or FEA or others or a combination of several techniques. These need to be recorded and presented here. | When designing the base support for the motor and the brackets to hold the end support of the X axis. We made sure that the length of this base was sufficiente for the travel distance of the saddle and also to support the motor. | Design
 | 2.3 Evaluate multiple solutions against analysis criteria | There is never the one correct solution to an engineering problem. You will evaluate a problem and arrive at a suitable solution. For example a structure which needs to carry a given load or a shaft needing to present a torque component. You can choose enhancing the design by changing the physical size of the components or the material from which it is made or redistribute the load etc. There is no one answer to the problem you need to give an example of you problem and your solution. | So far we have not used any analysis criteria | Project
 | 2.4 Apply systems thinking to problem solving and decision making | With the above example you can identify the problem solving technique you used to solve the problem. Or you may find a more appropriate example. Finding the right problem to solve Defining the problem Analysing the problem Developing possibilities Selecting the best solution Implementing Evaluating and learning. Or use SWOT or STAR etc. | N/A | Project
 | 2.5 Incorporate professional and technical assistance, as required | You need to collect evidence as the design progresses from concept to finished model. This evidence will clearly identify your contact with various stake holders as well as professional guidance from appropriately qualified people. For example your lecturer, firms supplying materials and others. | the lecturer adviced us about using laminated glass for the price and resistant. | Expert
 | 2.6 Apply specification, documentation and graphical techniques modelling, mock-up or prototyping techniques, where required, to achieve or test solution | Your final report will fulfil this requirement. The report will be written as a defined Engineering report. It will contain the abstract, Title page, Summary , Table of Contents, Introduction, Middle sections with numbered headings, Conclusions, References, Appendices; in the Appendices you will have all proprietary parts, all drawings as required in MEM 09155A, all calculations pertaining to the design. The report will also contain notes to the next group of students outlining what your experience has been and if this is an ongoing project a handover section in which your will give guidance to the next group. |  | CAD
3 Report results | 3.1 Record results of analysis | Your final report will fulfil this requirement. The report will be written as a defined Engineering report. Make sure your report contains the recording of any physical tests undertaken and their conclusions. |  | CAD
 | 3.2 Provide documentation, such as calculations, specifications, diagrams, CAD files, mock-ups or prototypes | Your final report will fulfil this requirement. The report will be written as a defined Engineering report. You will also present any prototypes made and other physical assets which have been generated during the project. | Along my progress report, I have provided PDF files for the making of the supports and brackets. | Project
 | Required Knowledge |  | Required Skill
 | · implications of life cycle design, fitness for purpose evaluation and sustainability for mechanical analysis process· implications of life cycle design, fitness for purpose evaluation and sustainability for mechanical analysis process | · mechanical engineering-related analysis processes and techniques to investigate, synthesise and develop proposals, evaluate feasibility against analysis criteria, and review and revise in consultation with stakeholders and team or support functional group· mechanical engineering-related analysis processes and techniques to investigate, synthesise and develop proposals, evaluate feasibility against analysis criteria, and review and revise in consultation with stakeholders and team or support functional group | · communicating and negotiating with stakeholders and team· communicating and negotiating with stakeholders and team
 | · common model, mock-up and prototyping techniques relevant to mechanical engineering· common model, mock-up and prototyping techniques relevant to mechanical engineering | · systems thinking, problem solving and decision making, and continuous improvement methods· systems thinking, problem solving and decision making, and continuous improvement methods | · determining or confirming relevance of mechanical engineering scientific principles and analysis techniques, including principles of:· determining or confirming relevance of mechanical engineering scientific principles and analysis techniques, including principles of:
 | · WHS and regulatory requirements, codes of practice, standards, risk management and registration requirements· WHS and regulatory requirements, codes of practice, standards, risk management and registration requirements | · sources of professional and technical assistance· sources of professional and technical assistance | · mechanics· mechanics
 | · procedures for planning, scheduling and coordination of analysis· procedures for planning, scheduling and coordination of analysis | · hardware requirements of typical mechanical, fluid power, hydrodynamic and thermal applications· hardware requirements of typical mechanical, fluid power, hydrodynamic and thermal applications | · fluid power· fluid power
 | · engineering scientific principles required for design analysis:· engineering scientific principles required for design analysis: | · mechanical· mechanical | · fluid dynamics· fluid dynamics
 | · fluid power· fluid power | · fluid dynamics· fluid dynamics | · thermodynamics· thermodynamics
 | · thermodynamics· thermodynamics | · electrical fundamentals· electrical fundamentals | · electrical fundamentals· electrical fundamentals
 | · engineering materials, properties and processes· engineering materials, properties and processes | · mechanical analysis calculation techniques· mechanical analysis calculation techniques | · engineering materials, properties and processes· engineering materials, properties and processes
 | · software for product planning and analysis, such as CAD, stress analysis and mould design, and project management | · documentation and required information | · evaluating WHS and regulatory requirements, standards and codes of practice for relevance to analysis tasks· evaluating WHS and regulatory requirements, standards and codes of practice for relevance to analysis tasks
 | · prototyping options, including mock-ups, physical and virtual modelling, and rapid prototyping |  | · evaluating multiple solutions against analysis criteria, risk, sustainability and cost factors· evaluating multiple solutions against analysis criteria, risk, sustainability and cost factors
 |  |  | · applying life cycle design and sustainability parameters to analysis task· applying life cycle design and sustainability parameters to analysis task
 |  |  | · planning, scheduling and coordinating the analysis task· planning, scheduling and coordinating the analysis task
 |  |  | · applying problem solving and decision making with systems thinking for contingencies and constraints and continuous improvement· applying problem solving and decision making with systems thinking for contingencies and constraints and continuous improvement
 |  |  | · specifying, documenting and applying graphical techniques, including modelling· specifying, documenting and applying graphical techniques, including modelling
 |  |  | · undertaking or supervising mock-up or prototyping techniques, where required, to achieve solution· undertaking or supervising mock-up or prototyping techniques, where required, to achieve solution
 |  |  | · creating and maintaining adequate and accurate calculations and analysis process records· creating and maintaining adequate and accurate calculations and analysis process records
 |  |  | · reporting and documenting results of investigations, application of principles and techniques, calculations, specifications, diagrams, CAD files, mock-ups or prototypes of designs
MEM 23120A | SELECT MECHANICAL MACHINE AND EQUIPMENT COMPONENTS
Element | Criteria |  | Student Evidence | Category
1 Establish scope of machine components selection task | 1.1 Identify stakeholders to be consulted on selection tasks | Stakeholders are people, groups or organisations that have an interest in or might be affected by the outcome of a project. You will show who you have consulted and why. | I consulted Miguel when he finished the forces calculations so once I knew the size of the ball screw, I was able to find the 3D modelling or drawing the parts (supports and nut) for the respective ball screw, to later do the final assembly. | Project
 | 1.2 Determine relevant compliance requirements of work health and safety (WHS) and regulatory requirements, codes of practice, standards, and risk assessment requirements for machines and equipment | WHS is a constant ongoing consideration. Show evidence of your participation within the simulated working environment and your constant acceptance of designing an inherently safe system. For example your use of the FABLAB and the safety which is required. OR when we visit a factor what safety requirements you had to follow. Also show how you have considered WHS in your design ensuring appropriate standards are met. Show how you have managed a risk either within the design or when manufacture takes place. | We recommended voice control for the lathe, and a satefy feature of stopping the lathe when something (sleeves for example) are trappped. | OHS
 | 1.3 Review features and functions of mechanical machines and components | There is never the one correct solution to an engineering problem. You will evaluate a problem and arrive at a suitable solution. For example a structure which needs to carry a given load or a shaft needing to present a torque component. You can choose enhancing the design by changing the physical size of the components or the material from which it is made or redistribute the load etc. There is no one answer to the problem you need to give an example of you problem and your solution. | When designing the first prototype base support for the motor of the X axis, my classmate and I showed it to the techinican and he recommended to improve the design by adding better trust support to the base to be stronger. | Design
 | 1.4 Investigate sustainability implications of component selection task | We will be discuss the engineering requirements of your project. You need to record how the project was developed with sustainability and life-cycle in mind. It is vital today that engineering designs have an acceptable life-cycle and are sustainable. You will discuss the use of various materials and the end of life recycling. You are required to record such discussions and present them for this criteria. This may be a short note on the change of design to meet the above criteria or how this was discussed before the project commenced or how the project changed to ensure an acceptable life or how the maintenance of the product changed an initial design. |  | Sustainability
 | 1.5 Establish availability of technical and professional assistance | You need to collect evidence as the design progresses from concept to finished model. This evidence will clearly identify your contact with various stake holders as well as professional guidance from appropriately qualified people. For example your lecturer, firms supplying materials and others. | the lecturer adviced us about using laminated glass for the price and resistant. | Expert
2 Examine technical specifications for component selection. | 2.1 Confirm performance requirements of particular machines or equipment components | Through out the design process we will investigate the requirements of the mechanism overall as well as the various components which make up the project. You will need to show how you have been involved with the project and the components you have designed and how you have undertaken the analysis of the component to ensure it is capable of adequate performance within the device. You need to show that you understand and have taken the performance of the component into account For example a shafts performance has been identified (stress strain, torque loading, cycle load and life cycle) so you are confident that it will perform as required. |  | Project
 | 2.2 Select appropriate analysis techniques using graphs, tables, nomograms or computer-aided solutions, as appropriate | Over the course of the project we will be developing the design using various analysis techniques you should compile these so you may present them as evidence of your use of analysis techniques. | Trial and Error | CAD Modelling
 | 2.3 Analyse operating conditions of components and determine component selection criteria | The most appropriate analysis technique will be used to evaluate various components within the project. Keep these for evaluation. The components within the design will be evaluated with the selection of materials, size and profile. Archive the progression of the design as evidence of continues improvement of the design. |  | Project
 | 2.4 Review design loads, working stresses, allowable deformations and factor of safety for machine components | The most appropriate analysis technique will be used to evaluate various components within the project. Keep these for evaluation. design loads, working stresses, allowable deformations and factor of safety for machine components. These will be constantly reviewed during the course of the design. | For the selection of the ball screw diameter, previously the power motor and loads (cutting load, tangetial cutting force, cutting speed, depth of cut etc.) were analysed for their selection. | Design
 | 2.5 Determine component arrangement, limits, fits and clearances, assembly, fastening and alignment methods | As part of the design you are involved you are required to detail your components. You are required to produce Detail Drawings incorporation all elements of the component. These components will be interoperated in the overall design with the correct fits and aligned. You will present these components for your assessment. | In the design of the brackets to support the Xaxis' nut and supports are part of this detailed elements that they will be assembled together to form a final component. For example, the final positioning of the X axis. | CAD
3 Select machine components. | 3.1 Specify arrangement and assembly requirements | The report will incorporate Assembly drawings as well as detail drawings, assembly instructions and maintenance plans. This is how this criteria will be assessed. | I reproduced final detailed drawings of the brackets and support for the technicians to be able to make them. | CAD
 | 3.2 Advise stakeholders of selection and make any required adjustments | As part of the report any recommendations to either future students or recommendations to the stakeholders will be incorporated. |  | Project
 | 3.3 Ensure traceability of analysis and component selection | The life of all components and any specific maintenance requirements are held in the report. Material selection, size, shape etc are incorporated in the report and are required for this criteria. |  | Project
4 Report results. | 4.1 Record results of scoping, principles and techniques identification and component selection procedures | This will be incorporated in the report. You are required to ensure these elements are held within the report. |  | Project
 | 4.2 Provide documentation, such as calculations, estimations, specifications, diagrams and drawings | This will be incorporated in the report. You are required to ensure these elements are held within the report. |  | Project
 | Required Knowledge |  | Required Skill
 | · WHS and regulatory requirements, codes of practice, standards and risk management requirements relevant to mechanical component selection processes· WHS and regulatory requirements, codes of practice, standards and risk management requirements relevant to mechanical component selection processes | · current options and trends in performance analysis software, including underpinning program techniques and software validation techniques· current options and trends in performance analysis software, including underpinning program techniques and software validation techniques | · applying safe working practices and procedures when working with machines and equipment· applying safe working practices and procedures when working with machines and equipment
 | · conditions for equilibrium· conditions for equilibrium | · reactions at beam supports (e.g. simply supported, overhung and cantilever beam with vertical and oblique concentrated, uniform and variable distributed loads and couples)· reactions at beam supports (e.g. simply supported, overhung and cantilever beam with vertical and oblique concentrated, uniform and variable distributed loads and couples) | · component arrangement, limits, fits and clearances, assembly, fastening and alignment methods· component arrangement, limits, fits and clearances, assembly, fastening and alignment methods
 | · shear force and bending moments, including diagrams· shear force and bending moments, including diagrams | · vertical and oblique concentrated and uniform and variable distributed loads· vertical and oblique concentrated and uniform and variable distributed loads | · investigating sustainability implications of machine development, manufacture and use· investigating sustainability implications of machine development, manufacture and use
 | · bending and shear stresses· bending and shear stresses | · torsion distribution diagrams· torsion distribution diagrams | · reviewing features and functions of machines and components· reviewing features and functions of machines and components
 | · combined stresses· combined stresses | · properties of common machine and component materials· properties of common machine and component materials | · identifying design features of machines, equipment and components, including:· identifying design features of machines, equipment and components, including:
 | · stress concentration and fatigue due to alternating stresses· stress concentration and fatigue due to alternating stresses | · deflection of beams· deflection of beams | · loads· loads
 | · bolted and welded connections with central loads (bolted joints may include friction forces)· bolted and welded connections with central loads (bolted joints may include friction forces) | · static versus dynamic forces, balanced and unbalanced· static versus dynamic forces, balanced and unbalanced | · working stresses· working stresses
 | · dynamics and laws of rotational motion | · work and forms of mechanical energy and power | · allowable deformations and factor of safety· allowable deformations and factor of safety
 | · dynamic systems | · mechanical power and drive efficiency | · component arrangements· component arrangements
 | · mechanical drives | · stresses in flywheels | · limits and fits· limits and fits
 |  | · stresses in thin walled pressure vessels | · assembly, adjustment and fastening methods· assembly, adjustment and fastening methods
 | · block, band and disk brakes and clutches with single contact surface |  | · identifying relevant analysis support, such as graphs, tables, nomograms or computer-aided solutions and validation techniques· identifying relevant analysis support, such as graphs, tables, nomograms or computer-aided solutions and validation techniques
 | · mechanical couplings and devices | · dynamic balancing of rotating masses | · selecting and specifying machine and equipment components, arrangement and assembly requirements· selecting and specifying machine and equipment components, arrangement and assembly requirements
 |  |  | · communicating with stakeholders, professionals and technicians· communicating with stakeholders, professionals and technicians
 |  |  | · identifying and complying with relevant WHS and regulatory requirements and risk assessment procedures
 |  |  | · reporting and documenting results of component selection, including calculations, specifications, diagrams and drawings
MEM 30029A | USE WORKSHOP EQUIPMENT AND PROCESSES TO COMPLETE AN ENGINEERING PROJECT
Element | Criteria |  | Student Evidence | Category
1 Research common engineering workshop equipment and processes | 1.1 Identify sources of professional, technical and trade assistance | As part of the design project you are required to produce a physical product. This may take the form of a model, prototype or final product. Which ever your project requires you need to: ensure all the components are able to be manufactured in the appropriate techniques. The technique chosen is available the technique is used in industry the technique is available. To assist in this you may need to contact an appropriate person which may include various trades people, engineers, technicians etc. This you will need to record. | when the base support was designed, we showed to the technician the final prototype and he assured that is a professional design that he could be able to make. | Expert
 | 1.2 Identify common processes and techniques for working, shaping and joining metal, alloys and others materials | As the project progresses you will document its progress. For this outcome you will discuss and document workshop techniques which are able to be used in the component as well as the technique used in the project. eg. You may use 3D printing in your project but note that injection moulding is more appropriate for production. Or you may CNC a product from a single billet of material but note a casting more appropriate. |  | Workshop
 | 1.3 Identify common engineering hand and power tools and their applications | The use of hand and power tools will be used in the workshop as the design progresses. You may be asked to use these as part of the manufacture and construction of the project. You are to use these only if you feel competent and have been given the necessary instructions in the safe use of the device. |  | Workshop
 | 1.4 Identify common workshop equipment and applications | The use of all the equipment in the workshop is for your use. You may be asked to use these as part of the manufacture and construction of the project. You are to use these only if you feel competent and have been given the necessary instructions in the safe use of the device. These include both CNC and manual machines. The report will identify the machines used in the production of the components as well as suggested alternatives. |  | Workshop
2 Identify resources required to manufacture a simple engineered item | 2.1 Interpret design information from drawings and instructions | Interpreting drawings is part of engineering. You will need to show your understanding and ability to read drawings as well as your ability to generate AS1100 drawings with in the design. For this you will incorporate any drawings either proprietary or self generated in the design. | We generate 3D modelling from the suppliers company for us to be able to incorporate them in the final assembly and later do some simulations. Of course, but previously we needed to do some calculations to select the correct components to purchase from these companies. | Design
 | 2.2 Select processes and techniques appropriate to task and level of skill | The use of all the equipment in the workshop is for your use. You may be asked to use these as part of the manufacture and construction of the project. You are to use these only if you feel competent and have been given the necessary instructions in the safe use of the device. These include both CNC and manual machines. The report will identify the machines used in the production of the components as well as suggested alternatives. |  | Workshop
 | 2.3 Identify required tools, equipment, material and services | With in the design if a special tool is needed you will consult with your lecturer. The tool may be bought or an alternative sort. Materials for the project will be acquired from stock or purchased as part of the budget within the report. | After we design the brackets we adviced the lecturer and the technician about it, and they could confirm the stock about the material to make the base supports and brackets. | Design
 | 2.4 Prepare a simple work plan showing operational sequences, work priorities and optimal use of time and resource | The project will run with a GANTT chart this will be consulted prior to the start of each day. This will be presented as part of the report. |  | Project
3 Use workshop equipment and processes to manufacture a simple engineered item | 3.1 Correctly prepare materials and equipment for the required operations | The use of all the equipment in the workshop is for your use. You may be asked to use these as part of the manufacture and construction of the project. You are to use these only if you feel competent and have been given the necessary instructions in the safe use of the device. The safe use of the machines and the correct safe use of materials will be assessed as the project progresses. The lecturer will assist as required. The assessment will be by observation. |  | Workshop
 | 3.2 Use tools and machines safely and correctly | The use of all the equipment in the workshop is for your use. You may be asked to use these as part of the manufacture and construction of the project. You are to use these only if you feel competent and have been given the necessary instructions in the safe use of the device. These include both CNC and manual machines. Any miss use of any equipment will lead to an evaluation of your continued involvement in the program. |  | Workshop
 | 3.3 Follow work health and safety (WHS) procedures, standard operating procedures and supervisor instructions are correctly | The use of machinery is encouraged but it is voluntary. At no time is any machine or tool to be used without a supervisor present. You will be instructed in regards to WHS requirements. You will understand the Duty of Care we all have to one another and you will be assesed against these quite rigid constraints. The assessment will be via observation by your lecturer and others. | N/A | OHS
 | 3.4 Obtain assistance from appropriate persons in the event of problems and difficulties | The use of machinery is encouraged but it is voluntary. At no time is any machine or tool to be used without a supervisor present. You will be instructed in regards to WHS requirements. You will understand the Duty of Care we all have to one another and you will be assessed against these quite rigid constraints. If at any time a problem arises it is your responsibility to report the problem and only proceed when you are satisfied it is safe to do so. The assessment will be via observation by your lecturer and others. | We have not used machinery to produce any component. | Expert
 | 3.5 Follow safe work practices and procedures | You will be instructed in regards to WHS requirements. You will understand the Duty of Care we all have to one another and you will be assessed against these quite rigid constraints. If at any time a problem arises it is your responsibility to report the problem and only proceed when you are satisfied it is safe to do so. The assessment will be via observation by your lecturer and others. | haven't get to this stage. But , deassembling the lathe safe work practice were practiced. | OHS
 | 3.6 Implement hazard control measures, where practicable | Hazard mineralisation is a key part of engineering. In both your design and workshop practice you are to keep Hazard mineralisation in mind. If you can see in improvement to safety then you are obliged to bring this to the attention of your supervisor, lecturer or others. At no time should you leave a hazardous situation unreported. | N/A | OHS
 | 3.7 Complete item manufacturing and check against specifications and work plan | Any part you are responsible for manufacture (whether it is to produced by you or others) you are required to check the part against the drawing of that part. Only after you have placed the part in the project bin will it be deemed as fit for purpose. The assessment will be carried out during assembly. If the parts you were responsible for checking are as required then you have passed this assessment. |  | Workshop
 | 3.8 Clear work area of scrap and waste | After each workshop session you are required to clean the area, remove all scrap, put all tools back in their allotted location and all unused material back in the store. This will be completed before anyone leaves. To consistently not to comply with this directive you will no longer be able to participate in the workshop meaning you will need to repeat this unit. |  | Workshop
 | 3.9 Clean work and secure equipment and work area according to standard procedures | After each workshop session you are required to clean the area, remove all scrap, put all tools back in their allotted location and all unused material back in the store. This will be completed before anyone leaves. To consistently not to comply with this directive you will no longer be able to participate in the workshop meaning you will need to repeat this unit. |  | Workshop
4 Assess workshop equipment and processes to technical engineering activities and engineering design process | 4.1 Justify selected workshop processes in terms of design criteria | To achieve this criteria you will need to give a written outcome for one of the products for which you are responsible. You will identify the product and the manufacturing process used you will also suggest an alternative and which technique is most appropriate. In this you will consider material, quantity required equipment available, time constraints and more as required. |  | Workshop
 | 4.2 Assess selected tools and equipment for process safety and efficiency | All equipment is to be assessed for safety. This will become a standard procedure and will be assessed by observation. All equipment will be assessed in terms of safety, sharpness, ability to complete the task. |  | Workshop
 | 4.3 Evaluate task and workshop processes against typical technician work activities | Manufacturing is changing. The tools we use in the Fablab are not common to many workshops. We have the opportunity to work with these machines as well as CNC machines using CAD CAM and using the more traditional machines. As we progress through the project you will be asked to evaluate the manufacturing in terms of a typical manufacturing facility |  | Workshop
 | Required Knowledge |  | Required Skill
 | · task planning and sequencing of operations· task planning and sequencing of operations | · marking out tools, techniques and media· marking out tools, techniques and media | · reading, confirming and following information on written job instructions, manufacturer specifications, standard operating procedures, charts, lists, drawings and other applicable reference documents· reading, confirming and following information on written job instructions, manufacturer specifications, standard operating procedures, charts, lists, drawings and other applicable reference documents
 | · common measurement tools and techniques· common measurement tools and techniques | · allowances and tolerances· allowances and tolerances | · identifying hazards and applying safe work practices and risk control measures· identifying hazards and applying safe work practices and risk control measures
 | · common engineering materials· common engineering materials | · common hand tools and their applications· common hand tools and their applications | · communicating with appropriate persons· communicating with appropriate persons
 | · common fixed and portable power tools and their applications· common fixed and portable power tools and their applications | · common engineering machine operation· common engineering machine operation | · following oral instruction and standard procedures· following oral instruction and standard procedures
 | · common workshop techniques, such as hand and machine cutting, drilling, tapping, grinding, machining, welding, bending and shaping, and assembly· common workshop techniques, such as hand and machine cutting, drilling, tapping, grinding, machining, welding, bending and shaping, and assembly | · workshop and machine safety, hazard identification and hazard control | · applying numeracy, calculations and measurements within the scope of this unit· applying numeracy, calculations and measurements within the scope of this unit
 | · work holding methods | · basic tooling identification | · accurately transferring dimensions to work pieces· accurately transferring dimensions to work pieces
 | · speeds and feeds | · machine set-up and operation | · planning and sequencing tasks· planning and sequencing tasks
 | · cutting fluids and basic operational maintenance of machines | · assembly and fixing techniques, tools and accessories | · safely operating machines, hand tools and power tools· safely operating machines, hand tools and power tools
 |  |  | · setting up machines and tooling for basic operations· setting up machines and tooling for basic operations

Sheet: Categories
CAD
CAD Modelling
Career
Design
Expert
Legislation
OHS
Project
Sustainability
Workshop
