SMTAFE-Engineering/CNC-Lathe-Docs/Archive/Progress Reports/M228540 - Miguel Martins/First report (calculations for Torque and Forces progress report).docx

Miguel Martins Student ID: m228540

Progress report 1.

First aim:

Create a 3D and editable model of the lathe’s bed.

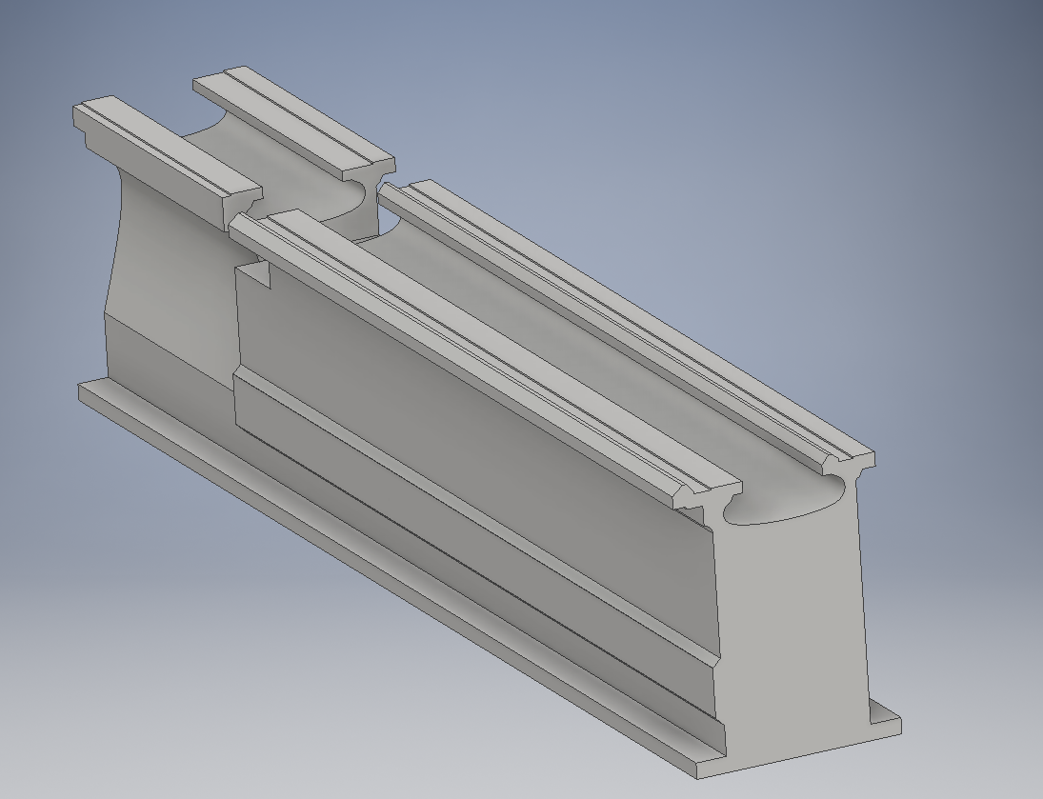
[picture p133: figure]

Second aim:

Calculate torques and forces exerted by the lathe to be able to select both motors and ball screws.

Initial stablished parameters:

Predominantly material for workpiece | High Carbon Steel | N/A
Depth of cut (max) | 6 | mm
Feed rate (max) | 0.5 | mm/rev
Chuck angular velocity (max) | 22 - 1800 | RPM
Coefficient of friction metal-metal | 0.16 [1] | N/A
Z-axis weight | 50 | Kg
X-axis weight | 25 | Kg
Manual angular velocity | 120 | RPM
Lead angle accuracy | 0.05 | mm
Ball screw length to be used for the Z-axis | 1100 | mm

CNC lathe is required to be driven by ball screws and servo motors for their lowest factors of frictions and accuracy respectively. Therefore all following calculations are aimed at selecting a ball screw and a servo motor which can overcome torque, velocity and forces developed by the lathe.

For cutting force calculation:


The approximate relationship of these components to each other is: F_T :F_A :F_R =4:2:1

Tangential cutting force ( F_t ) may be determined by:

F_T (N)=k_s ×a×s

Where k_s = specific cutting force (N/mm²)

a = depth of cut (mm)

s = feed (mm/rev)

As k_s = 2300 N/mm² for a workpiece of high carbon steel, it need to be corrected by three (3) factors which are insert geometry, entering angle of the tool and the feed rate chosen.


Assuming all these factors are equal to one, k_s is:

k_s =2300×1×1×1=2300 N/mm^2

Thus,

F_T =2300 N/mm^2 ×6 mm×0.5 mm/rev=6900 N

And:

F_A =(F_T)/2=(6900 N)/2=3450 N

F_R =(F_T)/4=(6900 N)/4=1725 N

Since the lead angle accuracy is 0.05 mm and the effective thread length is greater than 1000 mm, the accuracy grade for the ball screw will be C5 Precision Ball Screw [4]. Furthermore, most ball screw can provide an efficiency of 95%.

Additionally, the ball screw lead may be obtained as follow:

Lead=(Chuck angular velocity (RPM)×Feed rate ((mm)/(rev)))/(Manual angular velocity (RPM))=(1800×0.5)/120

=7.5 mm/rev

Rounding up the theoretical lead to match a standard lead screw ball from manufactures, lead is equal to 10 mm/rev. [5]

Once cutting forces and ball screw’s lead have been calculated, forces due to friction and lathe’s components weight must be included for both X and Z axes. Thus,

Z-axis (Apron) | X-axis (Tool post)

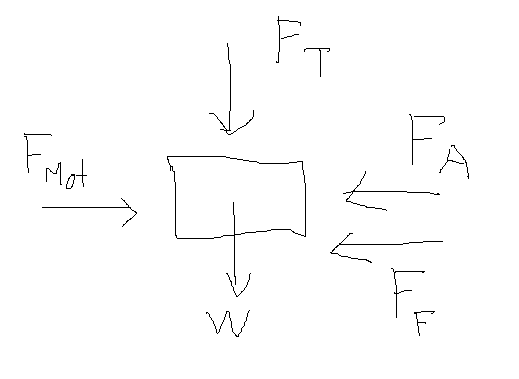
[picture p134: figure]
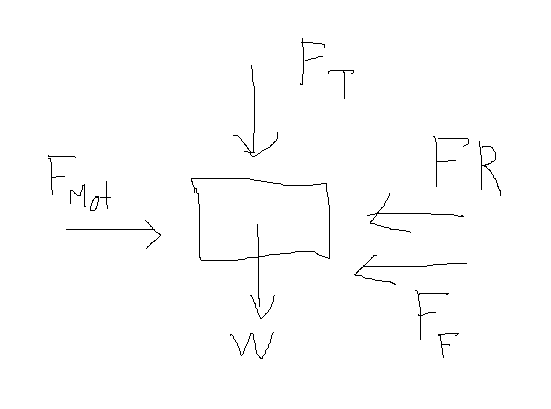
[picture p135: figure]

W=50Kg×9.81 m/s^2 =490.5 N | W=25Kg×9.81 m/s^2 =245.5 N
F_F =(6900N+490.5N)×0.16=1182.5N | F_F =(6900N+245.5 N)×0.16=1143.2N
F_(mot) =F_F +F_A =1182.5N+3450 N=4632.5N | F_(mot) =F_F +F_R =1143.2N+1725 N=2868.2N
T_(ball screw) =(F_(mot) ×Lead)/(2π×η_(ball screw) ×1000) =(4632.5N×10 mm/rev)/(2π×0.9×1000)=8.2 Nm | T_(ball screw) =(F_(mot) ×Lead)/(2π×η_(ball screw) ×1000) =(2868.2N×10 mm/rev)/(2π×0.9×1000)=5.1 Nm
T_(mot) =(T_(ball screw))/(η_(motor safety factor))=(8.2 Nm)/0.75 =10.9 Nm | T_(mot) =(T_(ball screw))/(η_(motor safety factor))=(5.1 Nm)/0.75 =6.8 Nm

Finally,

References

[1] Website for factor friction http://www.engineeringtoolbox.com/friction-coefficients-d_778.html

[2] Ross’ Book

[3] Selecting ball screw guide

[4] Lead angle accuracy

[5] Ball screw details
