SMTAFE-Engineering/CNC-Lathe-Docs/Archive/gantt chart - Copy.pdf

ID | Task Mode | Task Name | Duration | Start
1 | | Pulling apart lathe | 5 hrs | Tue 28/02/17
8 | | Measuring parts | 1 hr | Tue 28/02/17
19 | | Drawing parts in Inventor | 23 hrs | Wed 1/03/17
30 | | Searching information and selection | 286 hrs | Tue 7/03/17
39 | | Making the shopping list | 6 hrs? | Wed 26/04/17
40 | | Waiting for delivery of parts | 200 hrs? | Wed 26/04/17
41 | | Desigining supports of the screws, motors and sensors | 486 hrs? | Tue 7/03/17
42 | | Desinging protector cover for lathe | 6 hrs? | Tue 7/03/17
43 | | Cleaning lathe | 6 hrs? | Wed 31/05/17
44 | | Painting lathe | 6 hrs? | Wed 31/05/17
45 | | Installing new parts | 30 hrs? | Thu 1/06/17
46 | | Electrical connections and instalation | 30 hrs? | Thu 1/06/17
M | T | W | T | F | S | S | M | T | W | T | F | S | S | M | T | W
27 Feb '17 | 6 Mar '17 | 13 Mar '17

Task
Split
Milestone
Summary
Project Summary
Inactive Task
Inactive Milestone

Inactive Summary
Manual Task
Duration-only
Manual Summary Rollup
Manual Summary
Start-only
Finish-only

External Tasks
External Milestone
Deadline
Progress
Manual Progress

### Page 1

### Project: gantt chart Date: Tue 7/03/17

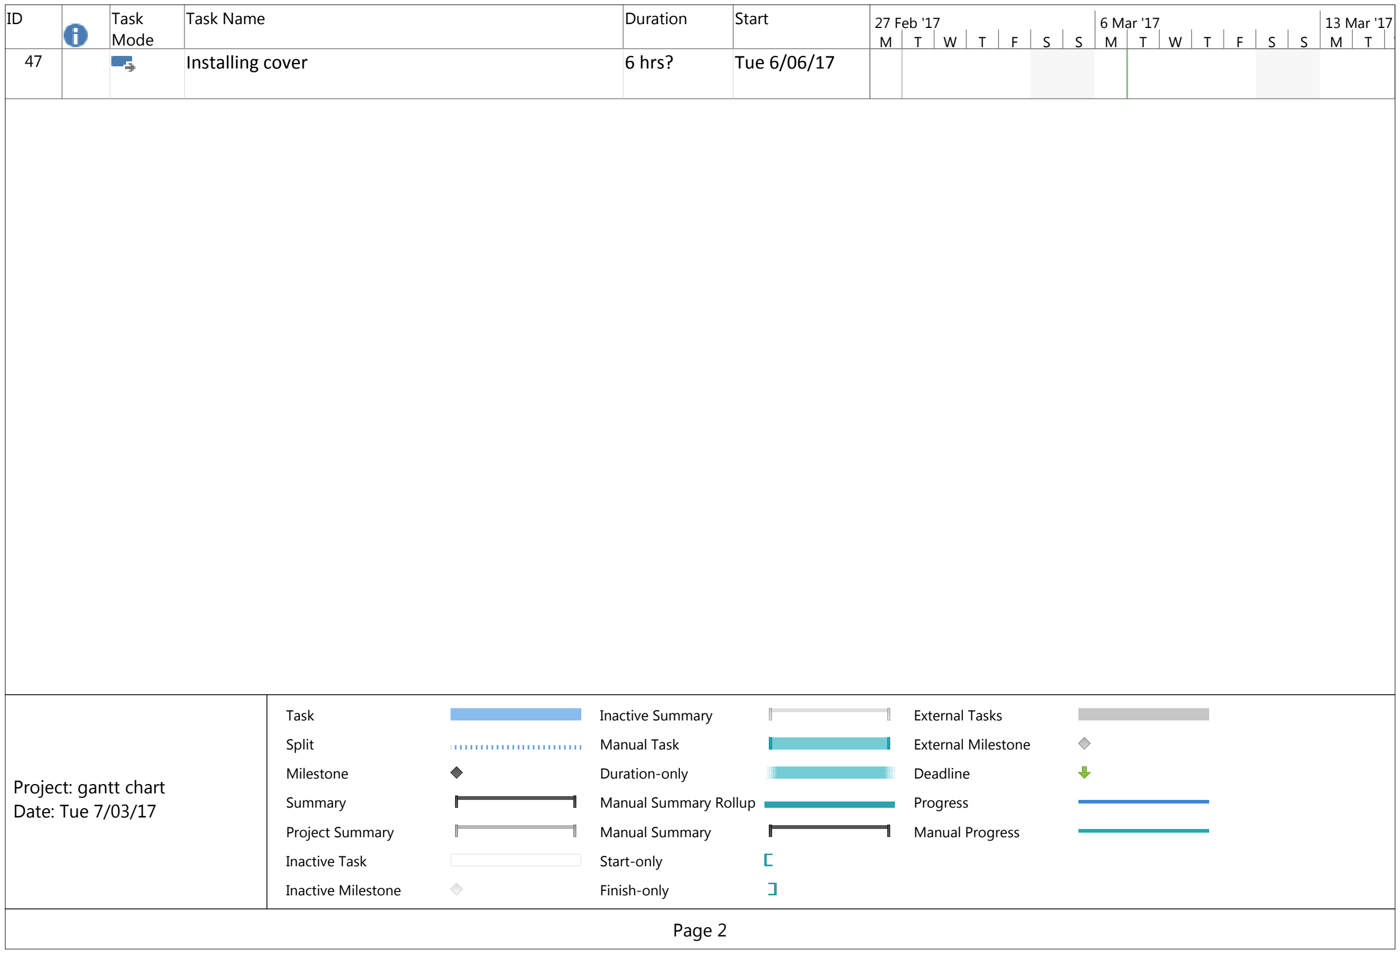
[picture p145: figure]
Task Mode; Task Name; Duration; Start; Installing cover; 6 hrs?; Tue 6/06/17; 27 Feb '17; 6 Mar '17; 13 Mar '17; Task; Split; Milestone; Summary; Project Summary; Inactive Task; Inactive Milestone; Inactive Summary; Manual Task; Duration-only; Manual Summary Rollup; Manual Summary; Start-only; Finish-only; External Tasks; External Milestone; Deadline; Progress; Manual Progress; Page 2; Project: gantt chart Date: Tue 7/03/17

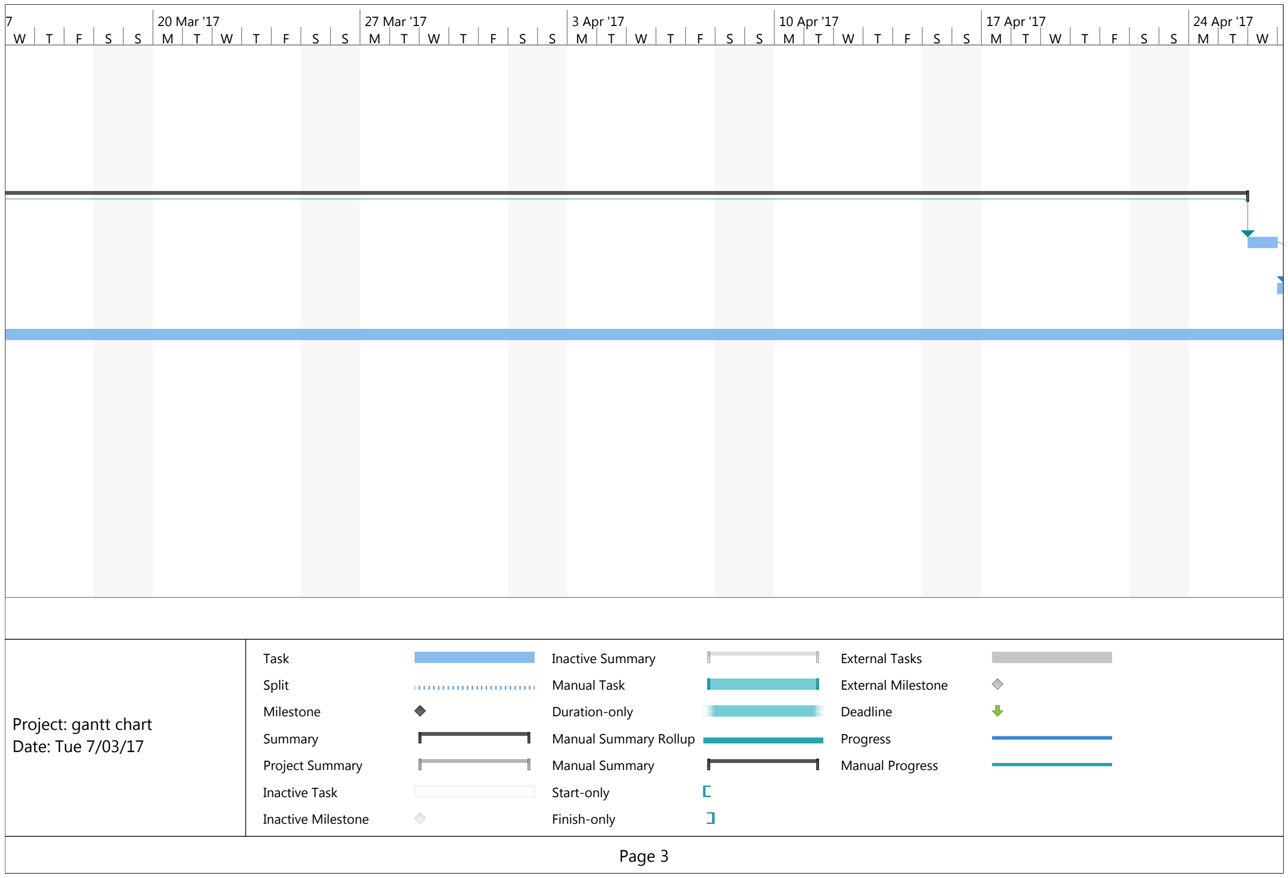
[picture p146: figure]
20 Mar '17; 27 Mar '17; 3 Apr '17; 10 Apr '17; 17 Apr '17; 24 Apr '17; Task; Split; Milestone; Summary; Project Summary; Inactive Task; Inactive Milestone; Inactive Summary; Manual Task; Duration-only; Manual Summary Rollup; Manual Summary; Start-only; Finish-only; External Tasks; External Milestone; Deadline; Progress; Manual Progress; Page 3; Project: gantt chart Date: Tue 7/03/17

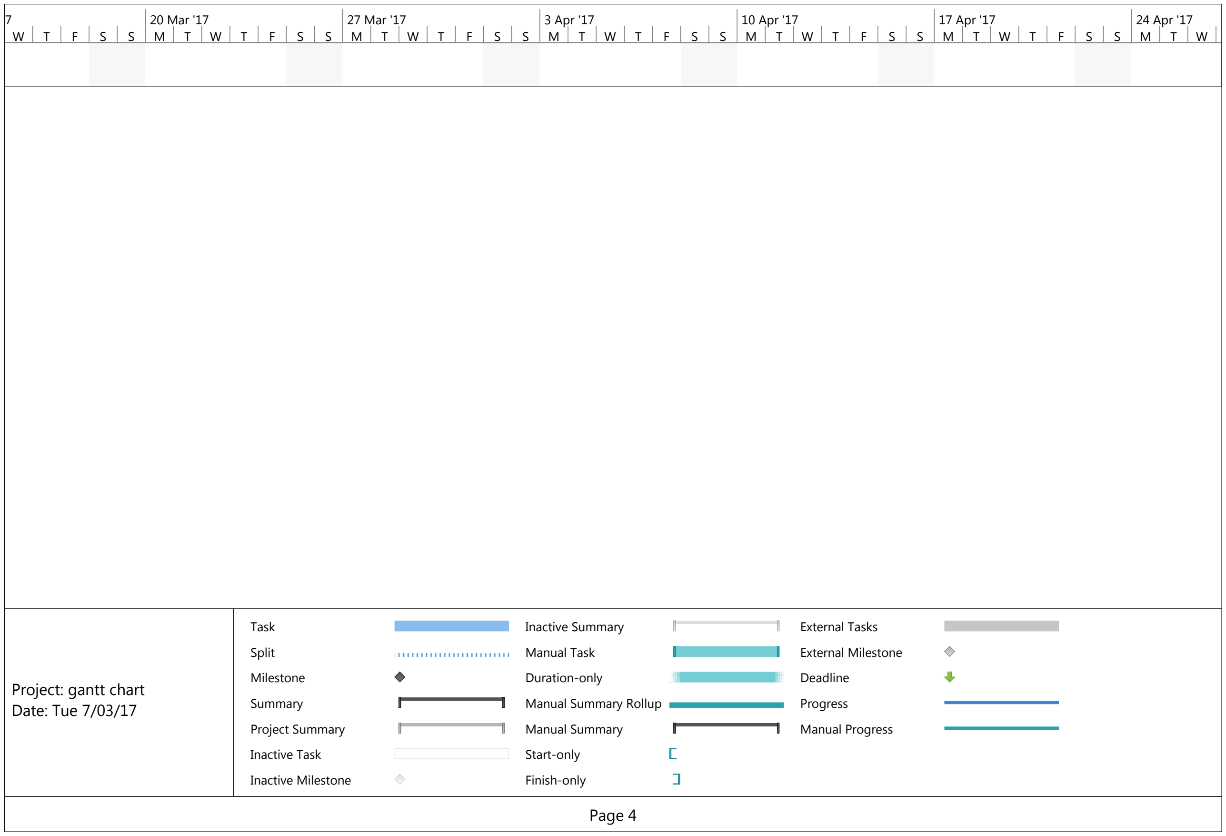
[picture p147: figure]
20 Mar '17; 27 Mar '17; 3 Apr '17; 10 Apr '17; 17 Apr '17; 24 Apr '17; Task; Split; Milestone; Summary; Project Summary; Inactive Task; Inactive Milestone; Inactive Summary; Manual Task; Duration-only; Manual Summary Rollup; Manual Summary; Start-only; Finish-only; External Tasks; External Milestone; Deadline; Progress; Manual Progress; Page 4; Project: gantt chart Date: Tue 7/03/17

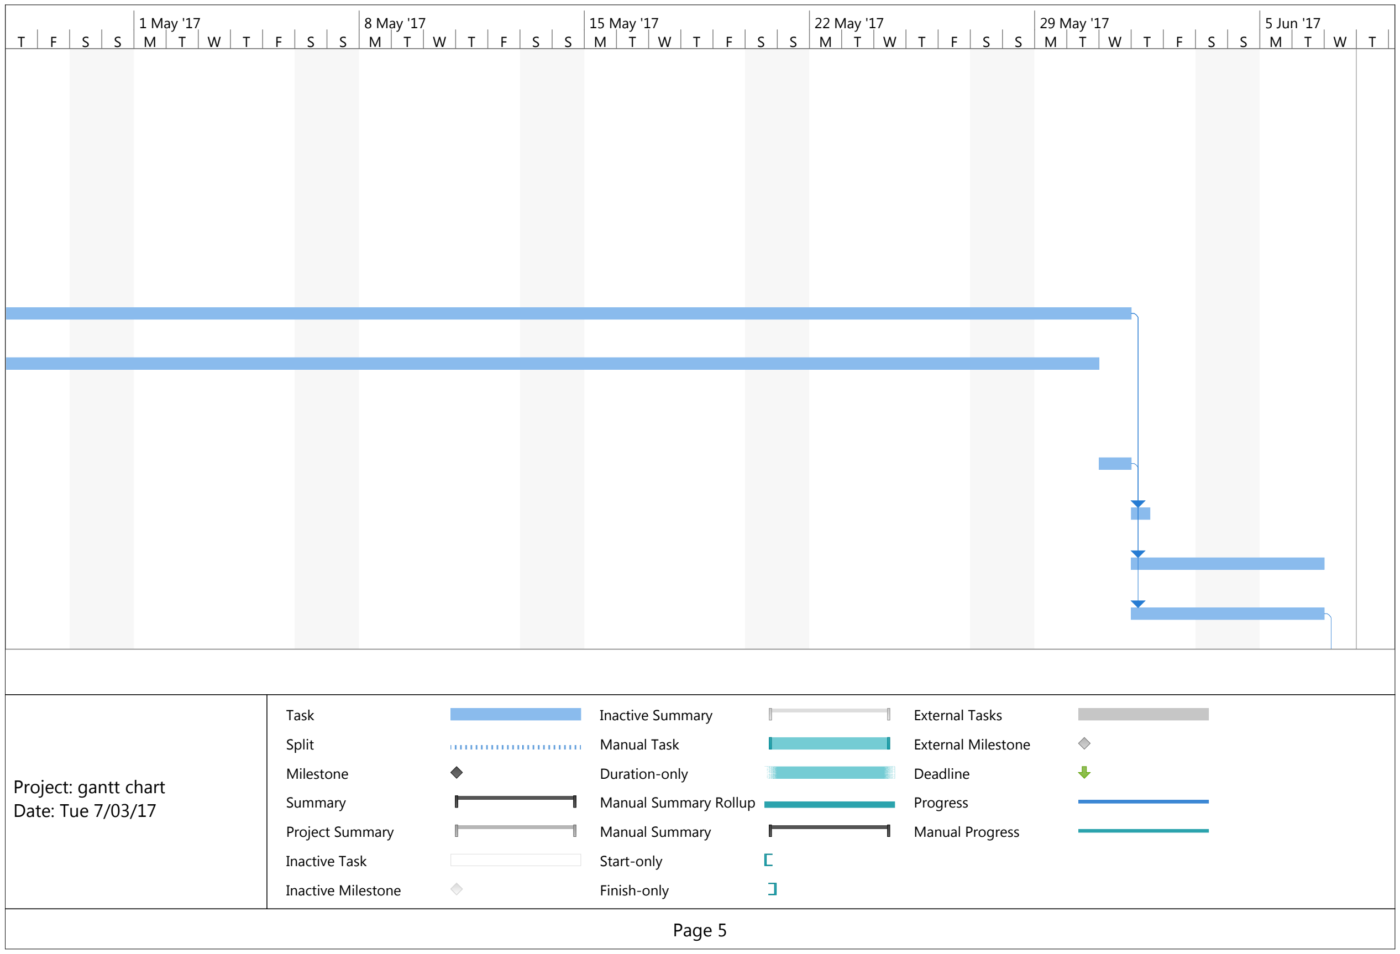
[picture p148: figure]
1 May '17; 8 May '17; 15 May '17; 22 May '17; 29 May '17; 5 Jun '17; Task; Split; Milestone; Summary; Project Summary; Inactive Task; Inactive Milestone; Inactive Summary; Manual Task; Duration-only; Manual Summary Rollup; Manual Summary; Start-only; Finish-only; External Tasks; External Milestone; Deadline; Progress; Manual Progress; Page 5; Project: gantt chart Date: Tue 7/03/17

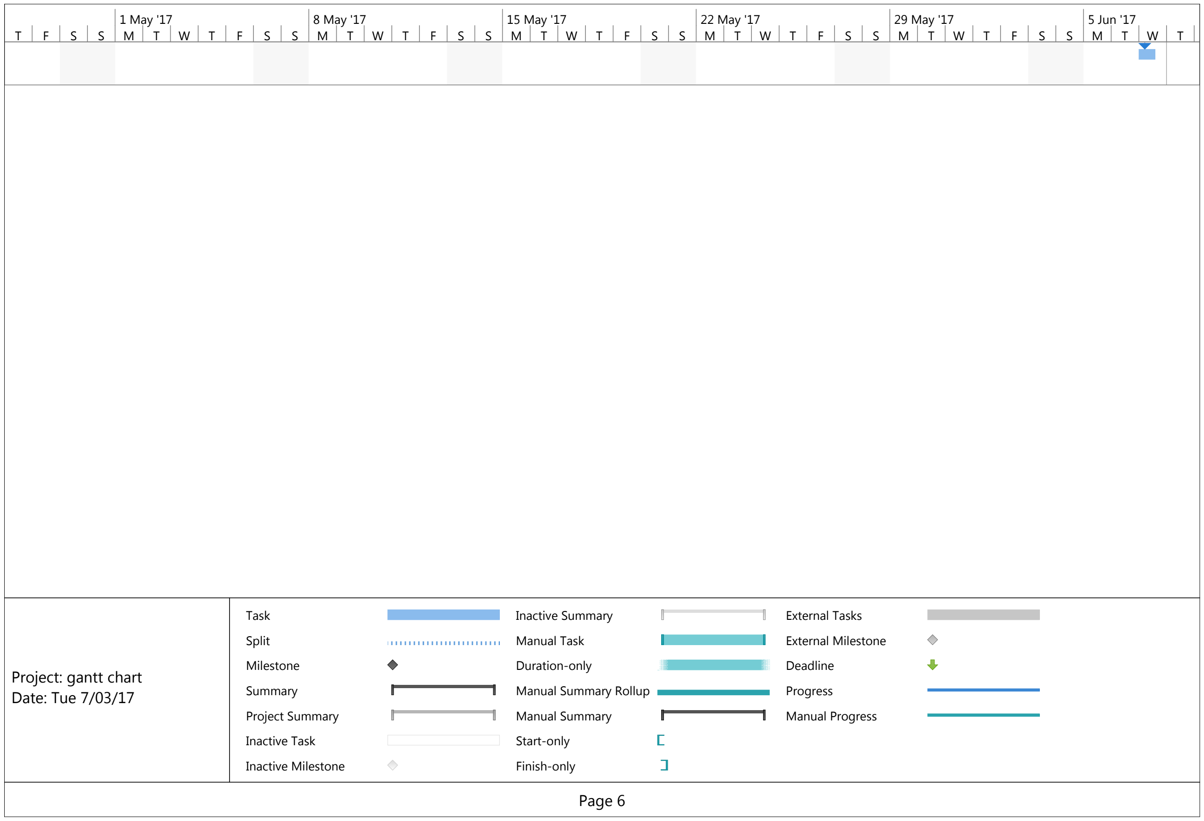
[picture p149: figure]
1 May '17; 8 May '17; 15 May '17; 22 May '17; 29 May '17; 5 Jun '17; Task; Split; Milestone; Summary; Project Summary; Inactive Task; Inactive Milestone; Inactive Summary; Manual Task; Duration-only; Manual Summary Rollup; Manual Summary; Start-only; Finish-only; External Tasks; External Milestone; Deadline; Progress; Manual Progress; Page 6; Project: gantt chart Date: Tue 7/03/17
