SMTAFE-Engineering/CNC-Lathe-Docs/2018/Lathe - Pre Hinge.png

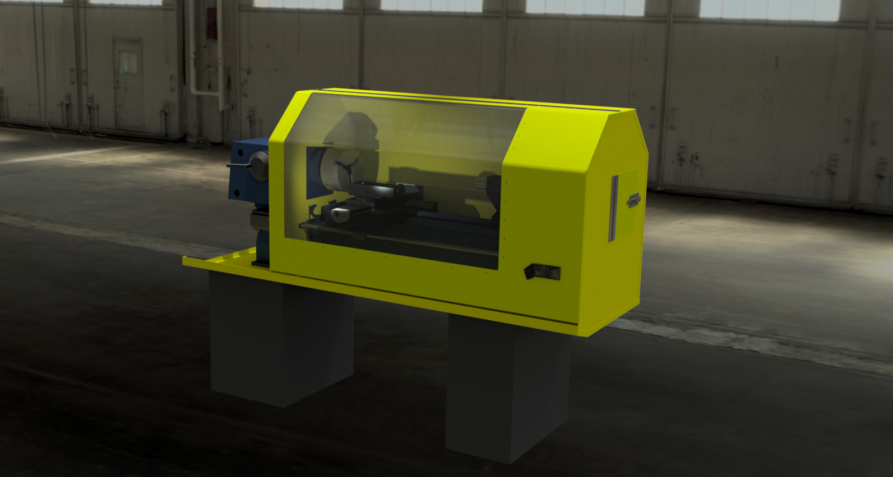
2018/Lathe - Pre Hinge.png
