SMTAFE-Engineering/CNC-Lathe-Docs/Alex's Files/EG7 wheel.png

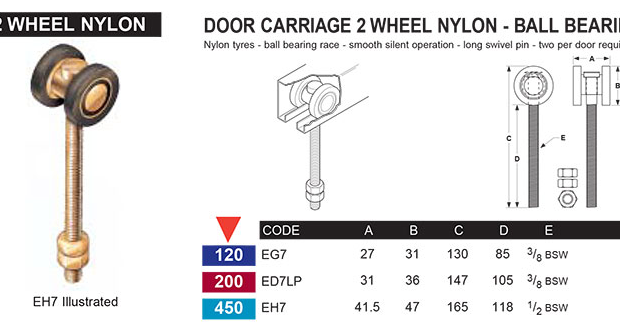
Alex's Files/EG7 wheel.png
