SMTAFE-Engineering/CNC-Lathe-Docs/Alex's Files/Rail EG2.jpg

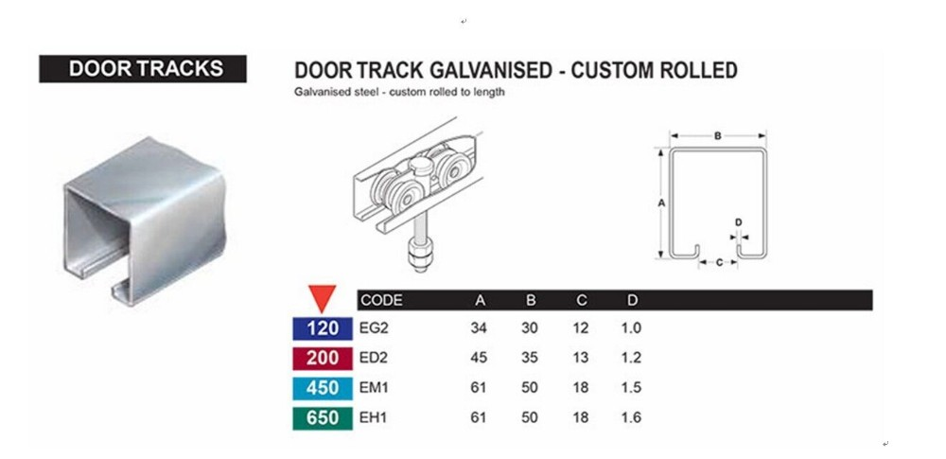
Alex's Files/Rail EG2.jpg
