SMTAFE-Engineering/CNC-Lathe-Docs/Lathe Progress/Early Design of Lathe V3 (x and y complete with gearbox handle)/6.PNG

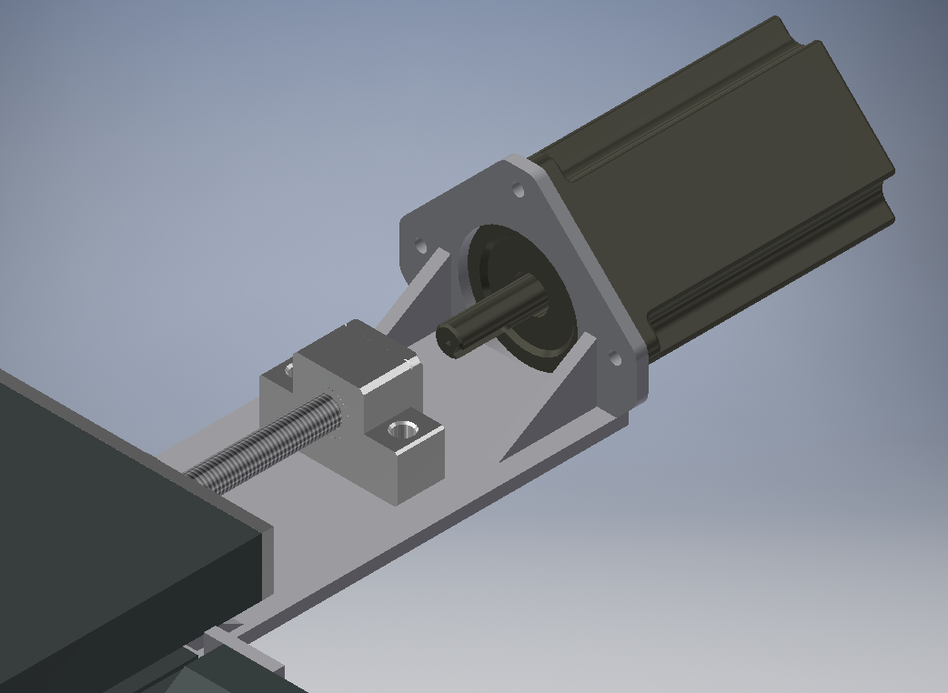
Lathe Progress/Early Design of Lathe V3 (x and y complete with gearbox handle)/6.PNG
