SMTAFE-Engineering/CNC-Lathe-Docs/Photos - Lathe cover/Cover with lathe photo.PNG

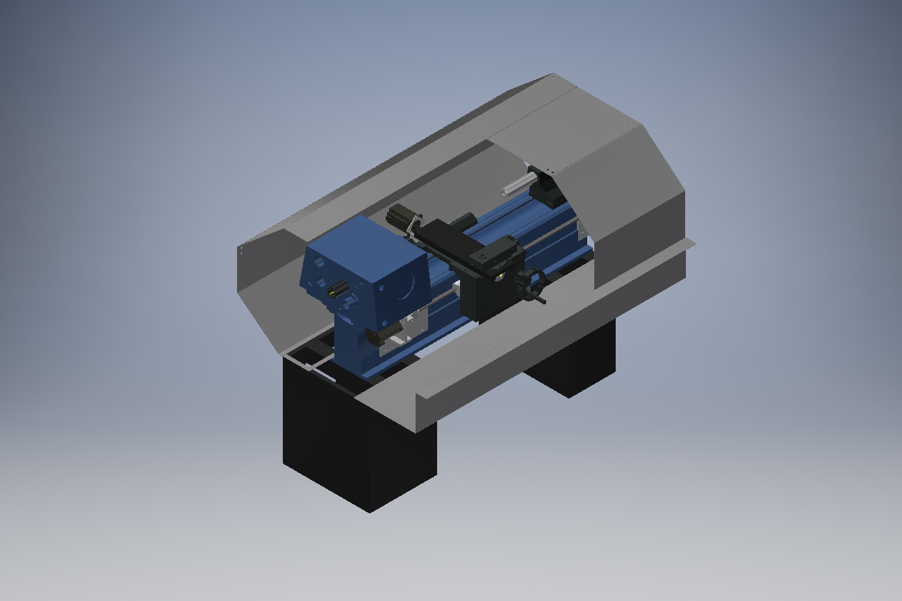
Photos - Lathe cover/Cover with lathe photo.PNG
