SMTAFE-Engineering/CNC-Lathe-Docs/Photos - Lathe cover/detail drawing photos/lathe cover.PNG

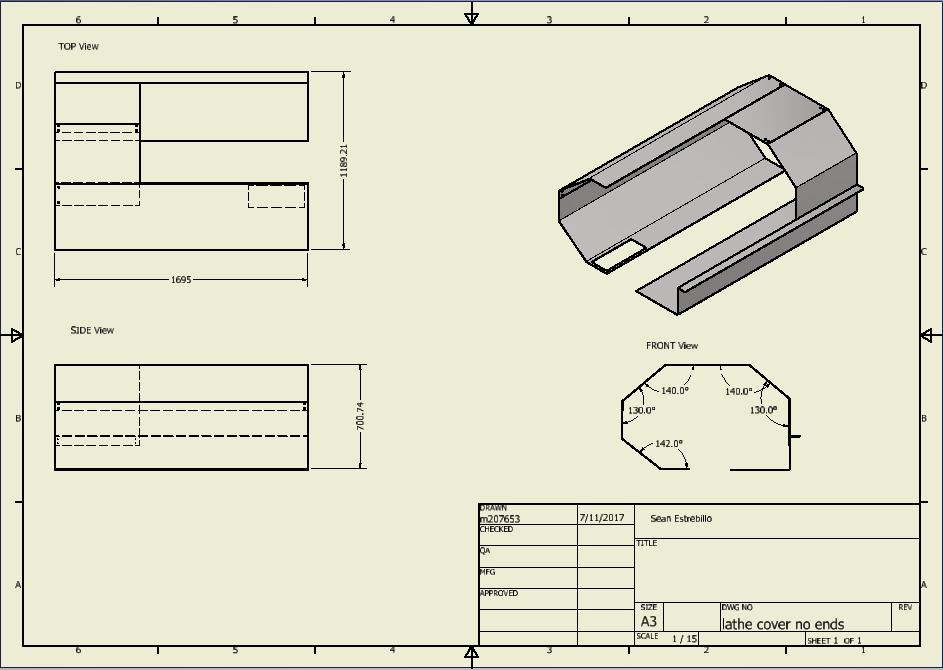
Photos - Lathe cover/detail drawing photos/lathe cover.PNG
