SMTAFE-Engineering/CNC-Lathe-Docs/Photos - Lathe cover/detail drawing photos/part1.PNG

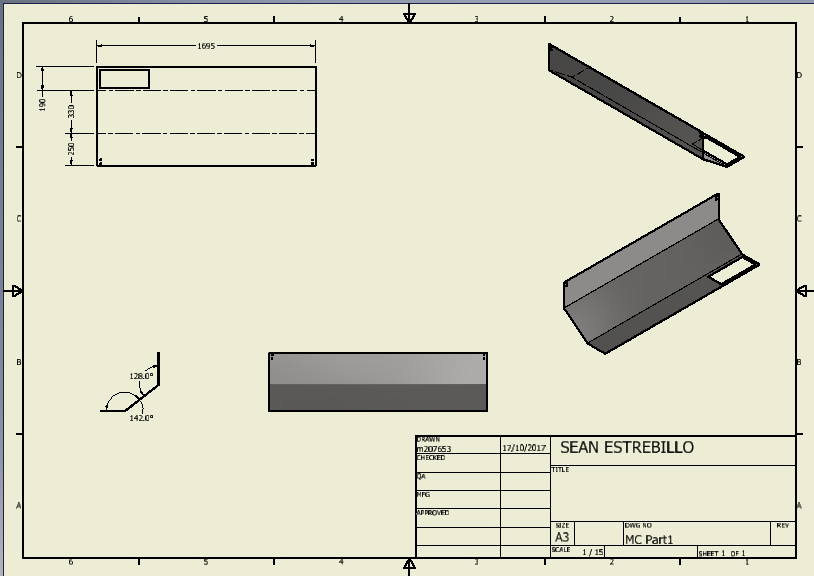
Photos - Lathe cover/detail drawing photos/part1.PNG
