SMTAFE-Engineering/CNC-Lathe-Docs/Photos - Lathe cover/detail drawing photos/part2.PNG

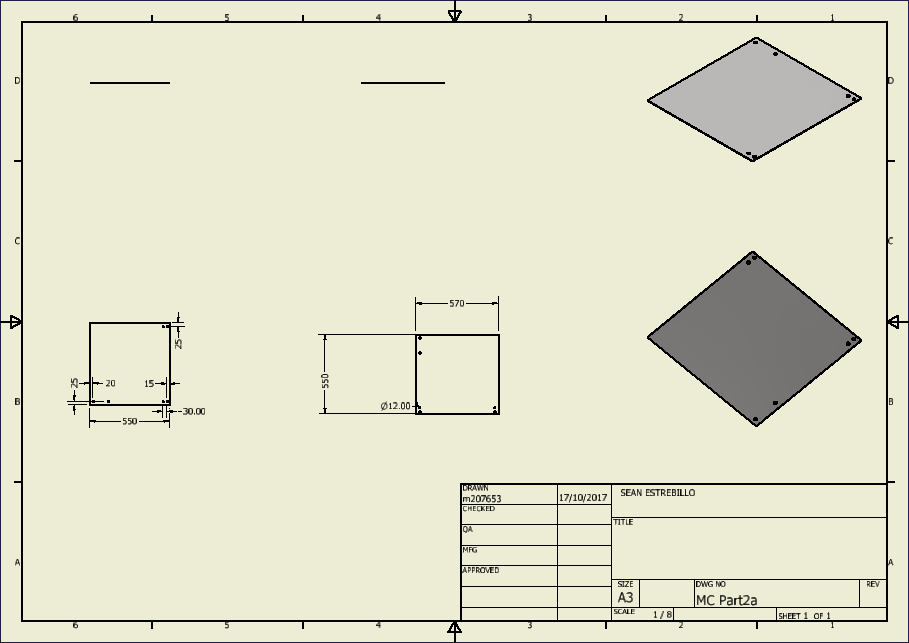
Photos - Lathe cover/detail drawing photos/part2.PNG
