SMTAFE-Engineering/CNC-Lathe-Docs/Photos - Lathe cover/detail drawing photos/part2b.PNG

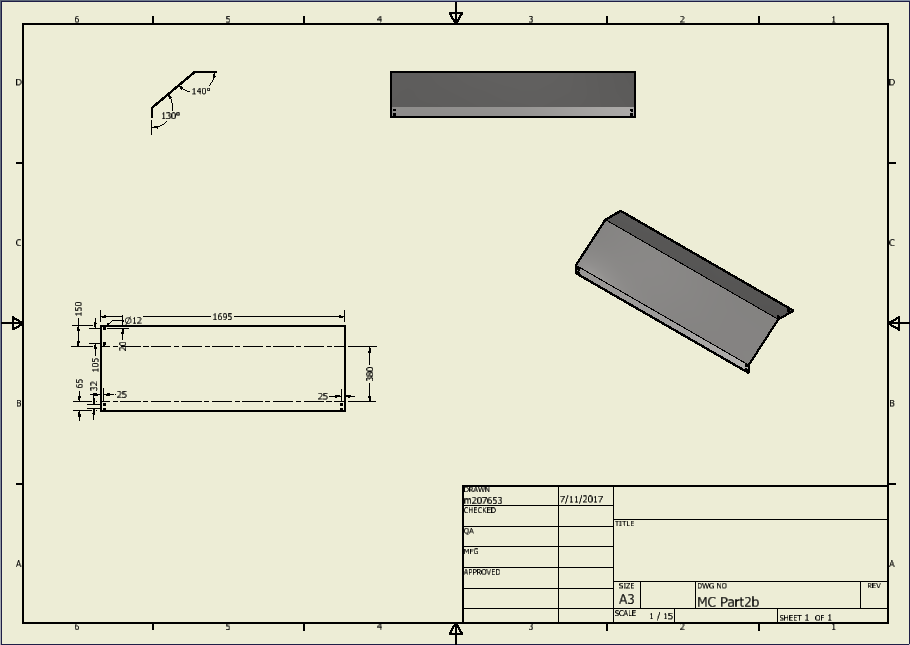
Photos - Lathe cover/detail drawing photos/part2b.PNG
