SMTAFE-Engineering/CNC-Lathe-Docs/Photos - Lathe cover/detail drawing photos/part3.PNG

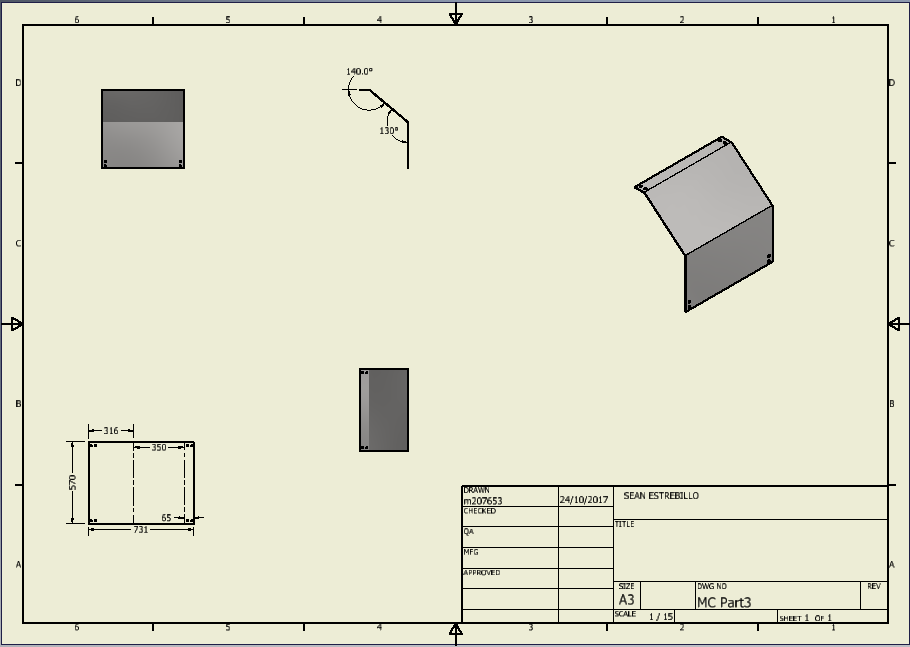
Photos - Lathe cover/detail drawing photos/part3.PNG
