SMTAFE-Engineering/CNC-Lathe-Docs/Photos - Lathe cover/detail drawing photos/part 4.PNG

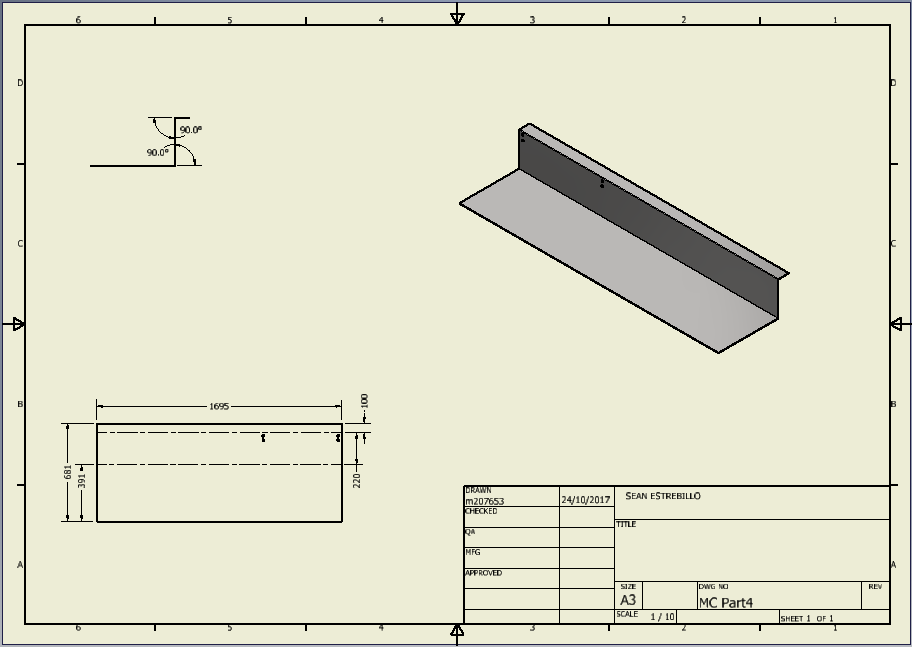
Photos - Lathe cover/detail drawing photos/part 4.PNG
