SMTAFE-Engineering/CNC-Lathe-Docs/Photos - Lathe cover/Lathe Cover Photo.PNG

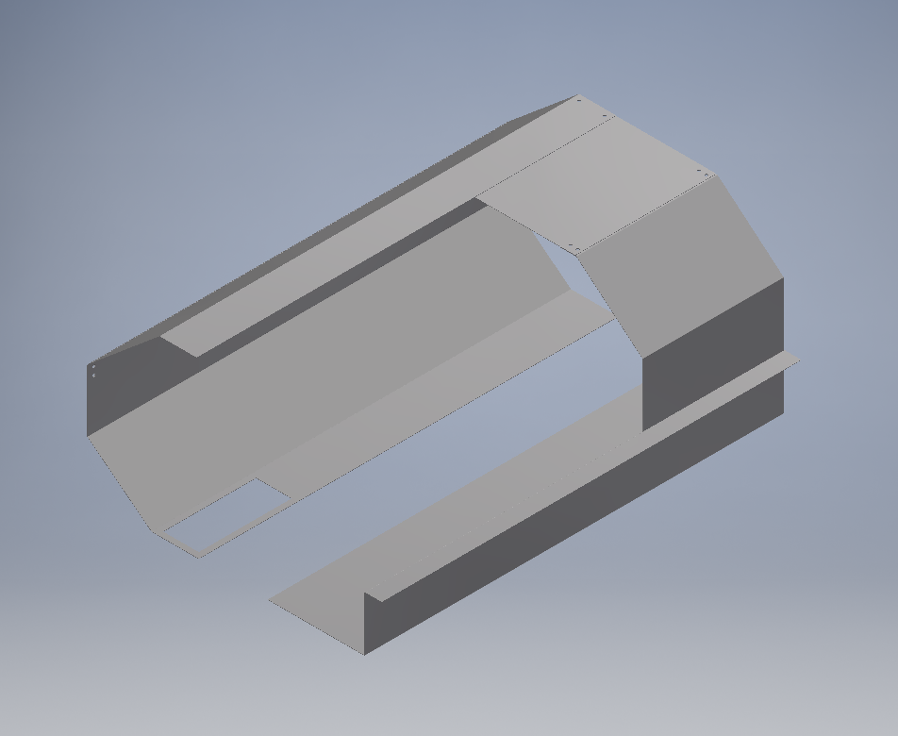
Photos - Lathe cover/Lathe Cover Photo.PNG
