SMTAFE-Engineering/CNC-Lathe-Docs/2018/2018 CNC Lathe Group Report/Material list for machined parts Glenn Lambert .docx

Materials required for in-house manufacture 12/6/2018
