SMTAFE-Engineering/CNC-Lathe-Docs/Budget of materials.xlsx

item | Specifications | Unit | Quantity | Price | Sub-Total | GST | Supplier | Delivery | Website
Servo motor | NEMA 34 Easy Servo Motor 8.0 N.m | unit | 2 | $289.00 | $578.00 | $57.80 | Ocean controls | $62.01 | https://oceancontrols.com.au/MOT-184.html
Servo motor driver | ES-D808 Easy servo driver, 80V, 8.2 A | unit | 2 | $229.95 | $459.90 | $45.99 | Ocean controls |  | https://oceancontrols.com.au/SMC-182.html
Power Cable (motor-driver) | 3.0 Metre Power Extension Cable for Easy Servo Motors (LSK-003) | Unit | 2 | $21.00 | $42.00 | $4.20 | Ocean controls |  | https://oceancontrols.com.au/LSK-003.html
Encoder Cable (motor-driver) | 3.0 Metre Encoder Cable for motor using the ES-D1008 Drives (LSK-010) | Unit | 2 | $21.00 | $42.00 | $4.20 | Ocean controls |  | https://oceancontrols.com.au/LSK-010.html
Motion Controller | 4-Axis Standalone Motion Controller with Ethernet Support G Code | Unit | 1 | $1229.00 | $1229.00 | $122.90 | Ocean controls |  | https://oceancontrols.com.au/SMC-648G.html
Power Supply | 1000W Mena Well RSP-1000-48 Single Output Switching Power Supply: 48VDC | Unit | 1 | $488.00 | $488.00 | $48.80 | Ocean controls |  | https://oceancontrols.com.au/PSM-2128.html
Rotary Encoder | Rotary Encoder - 1024P/R (Quadrature) with Shaft Coupler | Unit | 1 | $74.00 | $74.00 | $7.40 | Ocean controls |  | https://oceancontrols.com.au/SFC-019.html
Coupling Z-Axis | L-Coupling L075 14-12mm bore 10 N.m | unit | 1 | $0.00 | $0.00 | $0.00 | StateWideBearing | $0.00 | http://www.statewidebearings.com.au/wp-content/uploads/L-COUPLINGS.new_.pdf
Coupling X-Axis | L-Coupling L075 14-8mm bore 10 N.m | unit | 1 | $0.00 | $0.00 | $0.00 | StateWideBearing | $0.00 | http://www.statewidebearings.com.au/wp-content/uploads/L-COUPLINGS.new_.pdf
 |  |  |  |  | $2912.90 | $291.29 |  | $62.01
Sheets for Cover | 2740x1565mm required dimensions. | Unit | 1
Ball screw nut - Z axis | BNT 2010 - 2.6 | unit | 1 |  | $0.00 |  | THK
Ball screw shaft - Z axis | 1200mm of efective thread length. C5 Lead angle accuracy | unit | 1 |  | $0.00 |  | THK
Ball screw nut - X axis | BNT 1605 - 2.6 | unit | 1 |  | $0.00 |  | THK
Ball Screw shaft - X axis | 300mm of efective thread length. C7 Lead angle accuracy | unit | 1 |  | $0.00 |  | THK
Coolant pump | 180mm Leg COOLANT PUMP BARE - 415V . 60 L | unit | 1 | $319 | $319.00 |  | Hares and forbes | $11.00 | https://www.machineryhouse.com.au/P235
Coolant | XDP1800 - Soluble Metal Cutting Fluid of 20 L | unit | 3 | $192.5 | $577.50 |  | Hares and forbes | $11.00
Zincalume | 1 mm thick (1.2 m x 2.4 m) | sheet
Glass | Double or triple laminated glass | sheet
Electrical
Belt encoder | tooth belt | unit | 1 | $100 | $100.00 |  | Automated motion system
VSD | 3PH, 2.2/3.7KW | unit | 1 | $799.00 | $878.90 | $79.90 | Ocean controls | $20.35 | https://oceancontrols.com.au/TEM-104.html
Limit switches | cable inlet for M20*1.5 cable | unit | 4 | $24.63 | $108.37 | $9.85 | RS Australia | $0.00 | http://au.rs-online.com/web/p/limit-switches/9026871/
Inductor sensor | M8 3 pin connector | unit | 2 | $36.53 | $80.37 | $7.31 | RS Australia | $0.00 | http://au.rs-online.com/web/p/inductive-proximity-sensors/8054711/?sra=pstk
Reed Switch | Polypropylene Case 8mm Switching distance. 2 Wire | unit | 1 | $18.98 | $20.88 | $1.90 | RS Australia | $0.00 | http://au.rs-online.com/web/p/reed-switches/2897799/
Read switch Magnet |  | unit | 1 | $25.00 | $27.50 | $2.5 | RS Australia | $0.00 | http://au.rs-online.com/web/p/sensor-switch-magnets/2897812/?origin=PSF_421357|acc
Float level switch | M12 4 pin connector | unit | 4 | $18.65 | $76.46 | $1.86 | RS Australia | $0.00 | http://au.rs-online.com/web/p/level-sensors-switches/8697595/
Linix CNC Controler 2 |  | unit | 1 | $1523.50 | $1675.85 | $152.35 | General Mechatronics | $324.15
break out blocks |  |  | 2 | $30.00 | $66.00 | $6 | General Mechatronics | $50.00
 |  |  |  |  | $9756.63 |  |  | $540.52
