SMTAFE-Engineering/CNC-Lathe-Docs/2018/2018 CNC Lathe Group Report/Parts list May 2018 Glenn Lambert .docx

Lathe parts list May 2018
