SMTAFE-Engineering/CNC-Lathe-Docs/(list of files, cad)

Other CAD files:
X-axis/slide-ontop-of-saddle.dwg
X-axis/X-axis Ball Screw Support-1.dwg
X-axis/X axis screw support.dwg
X-axis/OldVersions/slide-ontop-of-saddle.0001.dwg
X-axis/OldVersions/X axis screw support.0001.dwg
X-axis/OldVersions/X-axis Ball Screw Support-1.0001.dwg
Alex's Files/Door Carriage 2 Wheel EG7 with moving wheels.iam
Alex's Files/Door Carriage 2 Wheel EG7.iam
Alex's Files/Door Carriage 2 Wheel.iam
Alex's Files/Folded Door with the Rollers.iam
Alex's Files/L Braket for Wheels.ipt
Archive/Alex's Files/Door Carriage 2 Wheel EG7 with moving wheels.iam
Archive/Alex's Files/Door Carriage 2 Wheel EG7.iam
Archive/Alex's Files/Door Carriage 2 Wheel.iam
Archive/Alex's Files/Folded Door with the Rollers.iam
Archive/Alex's Files/L Braket for Wheels.ipt
Archive/Ball Screw 1605 Short/BNT 1605-2_6 Nut.ipt
Archive/Ball Screw 1605 Short/BNT 1605-2_6 ZZ+346L C7T(3000).iam
Archive/Ball Screw 1605 Short/BNT 1605-2_6300 Shaft.ipt
Archive/Ball Screw 1605 Short/OldVersions/BNT 1605-2_6 Nut.0001.ipt
Archive/Ball Screw 1605 Short/OldVersions/BNT 1605-2_6 ZZ+346L C7T(3000).0001.iam
Archive/Ball Screw 1605 Short/OldVersions/BNT 1605-2_6300 Shaft.0001.ipt
Archive/saddle.ipt
