SMTAFE-Engineering/CNC-Lathe-Docs/Archive/Progress Reports/M228540 - Miguel Martins/Second report (supports, manufacturing drawings, assembly).docx

Miguel Martins Student ID: m228540

Progress report 2.

First aim:

Update lathe’s bed

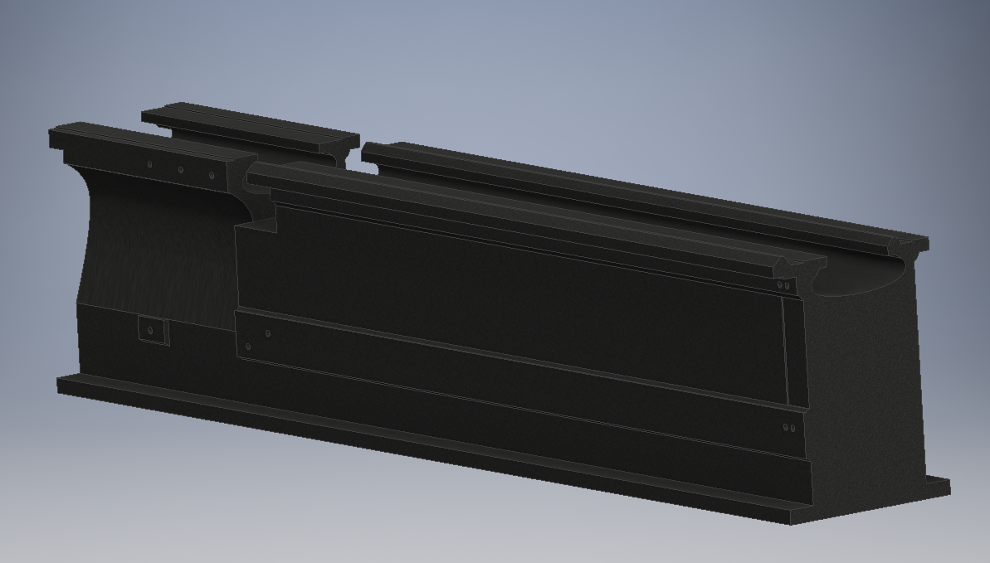
[picture p166: figure]

- Creation of holes to allocate motor and ball screw supports.
- Determine and specify the exact dimension and position of a zone to be grinded.
- Minor general dimension changes.

Second aim:

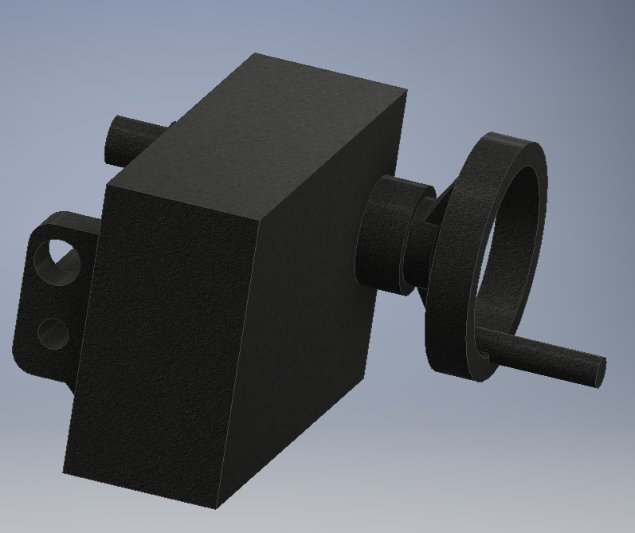
[picture p167: figure]
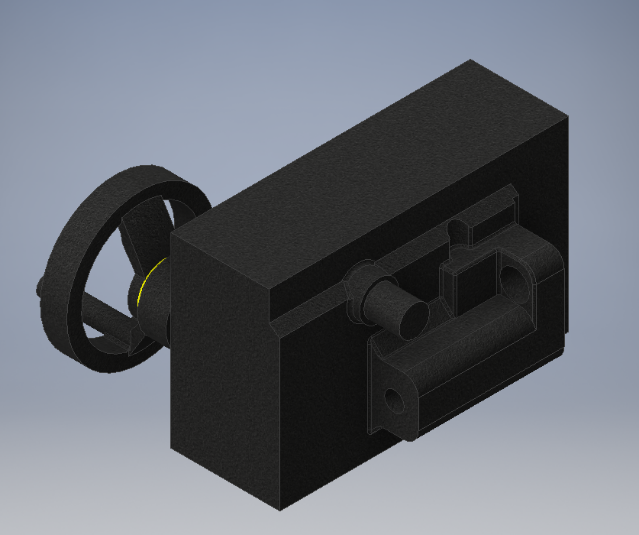
[picture p168: figure]

Create an editable and 3D model of the lathe’s apron.

Model includes material.

Third aim:

Elaborate a digital representation of the ball screw, nut and its support.

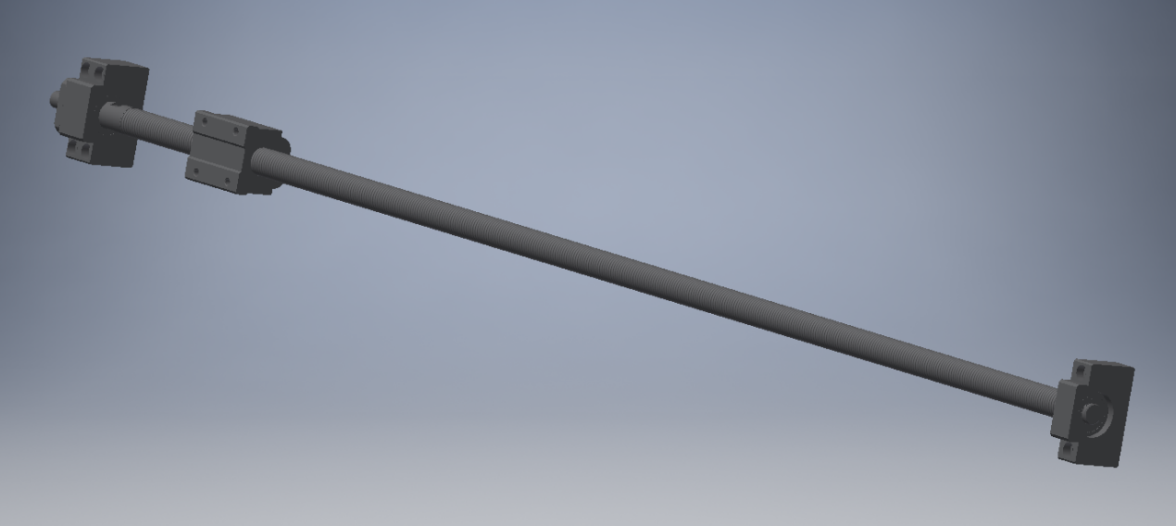
[picture p169: figure]

Found and generated online on the THK company website based on previous calculations carried out in the progress report 1. (http://www.thkstore.com/bnt-nut.html).

Fourth aim:

Assemble available parts into a restricted model.

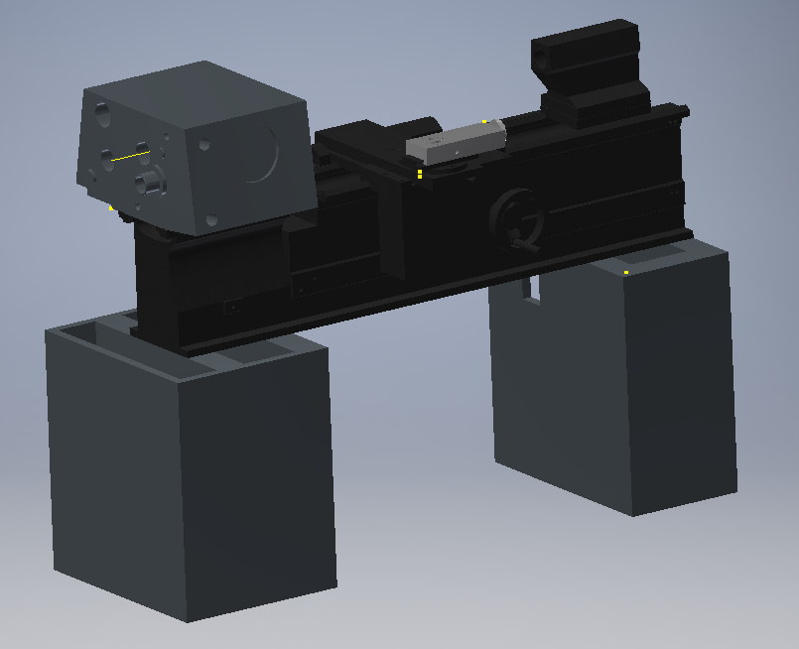
[picture p170: figure]

Fifth aim:

Design supports for both motor and ball screw and find the most suitable allocation for it on the bed.

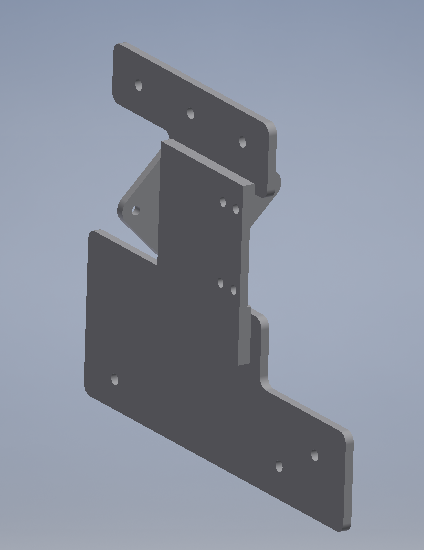
[picture p171: figure]
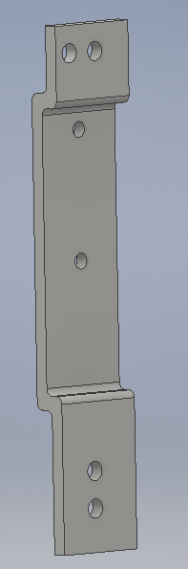
[picture p172: figure]
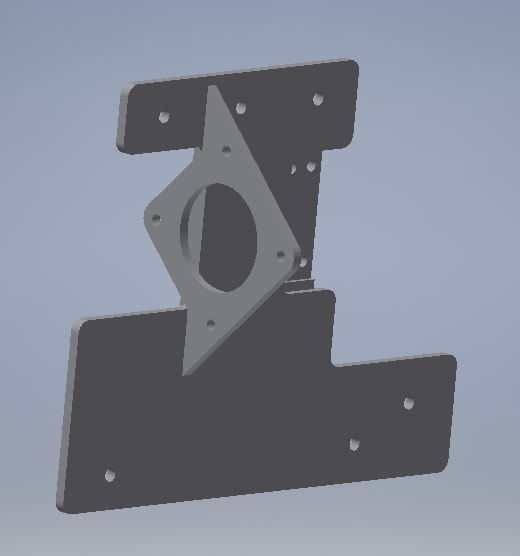
[picture p173: figure]
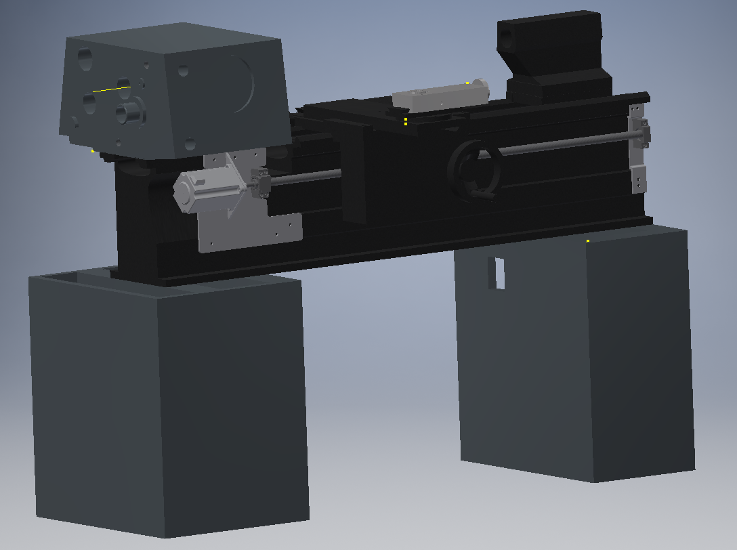
[picture p174: figure]

Sixth aim:

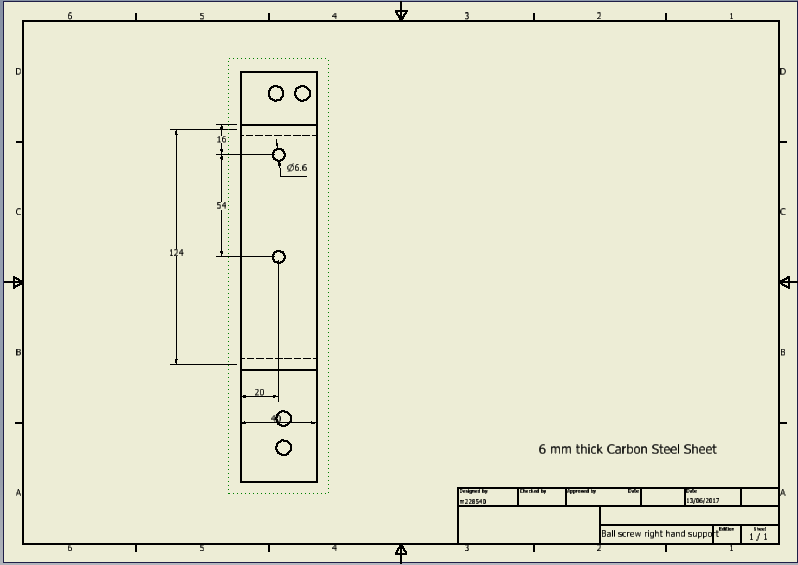
[picture p175: figure]

Produce manufacturing drawings for supports.

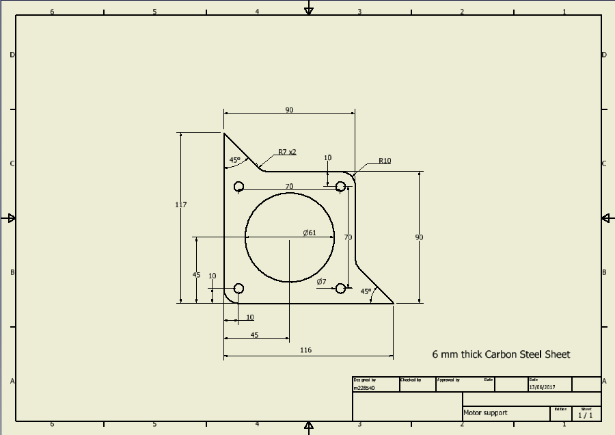
[picture p176: figure]
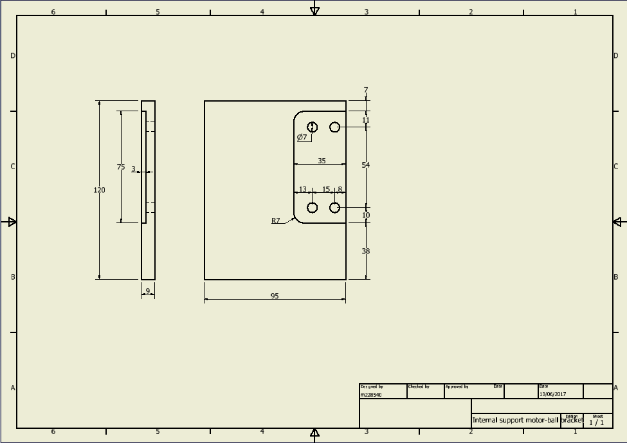
[picture p177: figure]
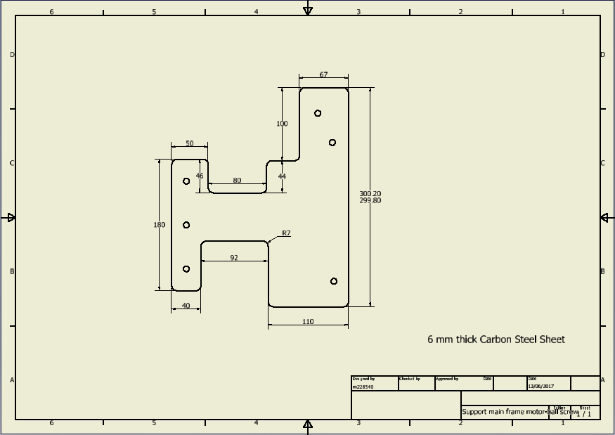
[picture p178: figure]
