SMTAFE-Engineering/CNC-Lathe-Docs/(commit log)

2017-08-15 Updated list of material
    Motors, Motor drivers, motion controller, power supply and rotary
    encoder
    [Budget of materials.xlsx, List of Materials (Motors, drivers, motion controller, cables, power supply and rotary encoder).xlsx]
2017-08-29 Progress report
    All the work I've done during the last weeks incluiding fabrication of
    ball screw' support and starting off spacer between apron and nut
2017-09-05 Added E-Portfolio folder and my e portfolio
    [Alex E-Portfolio.xls, Parts Check List.xlsx]
2017-09-10 My e-portfolio - M207653
    Still have questions to be filled
    [Sean Estrebillo - e-portfolio.xls]
2017-10-10 E- portfolio
    adding file for e-portfolio
    [Sandeep Singhe-portfolio.xls]
2017-11-28 Final reports
    Make a folder in here name it with your account number and name
    [e-Portfolio 10-02-17.xls]
2017-11-28 Final reports
    e-Portafolio and personal reports
    [e-Portfolio.xls]
2017-11-28 FINAL E PORTAFOLIO AND PERSONAL REPORT
    [e-Portfolio 10-02-17.xls]
2017-11-28 E-Portfolio - M207653
    Sean Estrebillo
    [Sean Estrebillo - e-port.xls]
2017-12-05 Progress Report August 2017
    Monthly report on LATH's X-axis. (29/08/2017)
2017-12-05 Personal report and E-portfolio
    [E-Portfolio For Lathe(UcTran).xls]
2017-12-05 E-portfolio - M207653
    Completed!!
    [Sean Estrebillo - e-port.xls]
2017-12-05 Final report and E-portofolio
    adding files for Final report and E-portofolio
    [Sandeep Singhe-portfolio.xls]
2017-12-05 Pictures of the Cover
    detail drawings and the assembly of the cover
2017-12-05 Lathe Progress V3
    x and y axis mounts + Gearbox handle. Note the y axis is going to be
    placed differently!
2017-12-05 Alex's Files
    most of my term 3 files
    [Door Carriage 2 Wheel EG7 with moving wheels.iam, Door Carriage 2 Wheel EG7.iam, Door Carriage 2 Wheel.iam, Folded Door with the Rollers.iam, L Braket for Wheels.ipt, M227562 Alex E-Portfolio .xls]
2017-12-05 Final Report and E Port
    [M227562 Alex E-Portfolio .xls]
2017-12-05 Lathe Cover Photo
    Cover assembled with the final Lathe version
2017-12-11 completed e portfolio
    was uploaded in final progress report file a week ago
    [Sean Estrebillo - e-port.xls]
2017-12-11 Final E Port Alex
    My Final E Portfolio
    [M227562 Final Alex E-Portfolio .xls]
2017-12-11 Final Report Again in a Different Spot
    [M227562 Final Alex E-Portfolio .xls]
2018-04-03 Updated Docs for 2018
    [Alex E-Portfolio.xls, BNT 1605-2_6 Nut.0001.ipt, BNT 1605-2_6 Nut.ipt, BNT 1605-2_6 ZZ+346L C7T(3000).0001.iam, BNT 1605-2_6 ZZ+346L C7T(3000).iam, BNT 1605-2_6300 Shaft.0001.ipt, BNT 1605-2_6300 Shaft.ipt, Ball Screw Info.xlsx]
2018-04-03 Minor Changes
    [Budget of Materials 2018.xlsx]
2018-05-15 Updated Budget
    [Budget of Materials 2018.xlsx]
2018-08-07 Contract Update
    [X axis screw support.0001.dwg, X axis screw support.dwg, X-axis Ball Screw Support-1.0001.dwg, X-axis Ball Screw Support-1.dwg, slide-ontop-of-saddle.0001.dwg, slide-ontop-of-saddle.dwg]
2018-10-30 Update 2018/Lathe - Pre Hinge.png
    Render
2018-11-13 Update 2018/Lathe - Pre Hinge.png
